gc9n/rx5808-Diversity-RealAcc-Compatible/README.md

<h1>V2.0 OSD Support (Menus-RSSI-Diversity-Battery) Fatshark Button Support</h1>

* Added OSD support for menus
* Ultra fast Real time RSSI feed back
* Ultra fast  Real time Diversity feed back
* PAL or NTSC recognition
* Goggles Battery monitor
* Fatshark Buttons Compatibility
* Favorites enhancement
* "Find Model" Feature

VIDEO

Diversity Module RealAcc with OSD (Real time RSSI-Diversity) and Fatshark button support (https://www.youtube.com/watch?v=VvQDdLFI8oQ)

Instructions 
https://oscarliang.com/realacc-osd-menu-button-support/

Theres an update in Diagram.

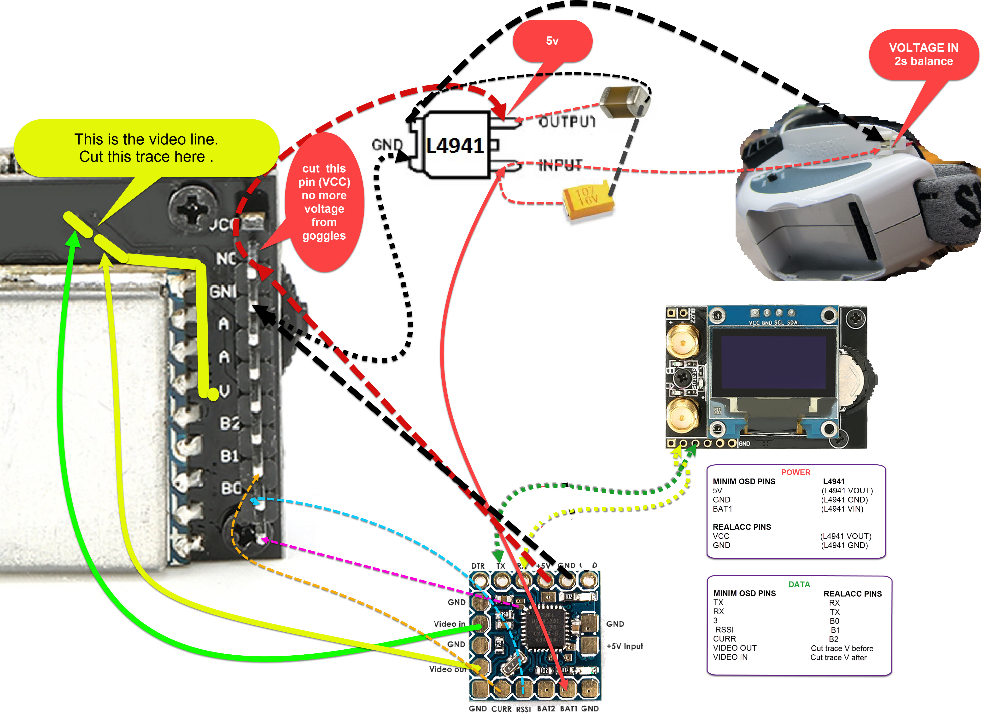
[picture p1: STEPS/STEP THREE (connections)/Realacc - MinimOSD mod .jpg]
 

If this project help you reduce time to develop, you can give me a cup of coffee :)

<a href="https://www.paypal.com/cgi-bin/webscr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" target="_blank">
   
</a> 

# rx5808-Diversity-RealAcc-Compatible
<h1>V1.0 RX5808 Diversity RealAcc Compatible</h1>
Based on sheaivey/rx5808-pro-diversity project

Added extra features with Favorites tab 

 <p align="center">
  
  
</p>

If this project help you reduce time to develop, you can give me a cup of coffee :)

<a href="https://www.paypal.com/cgi-bin/webscr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" target="_blank">
   
</a>
