gc9n/rx5808-Diversity-RealAcc-Compatible/STEPS/instructions.txt

OSD Support (Menus-RSSI-Diversity-Battery)  Fatshark Button Support

* Added OSD support for menus
* Ultra fast Real time RSSI feed back
* Ultra fast  Real time Diversity feed back
* PAL or NTSC recognition
* Goggles Battery monitor
* Fatshark Buttons Compatibility
* Favorites enhancement

VIDEO
Diversity Module RealAcc with OSD (Real time RSSI-Diversity) and Fatshark button support (https://www.youtube.com/watch?v=VvQDdLFI8oQ)

<h1>Powering the module from deferent power source</h1>
 What I realized is that the Fatshark Goggles have an internal regulator 5v that feeds the Video RX module when we plug it in … is less than 500mha. I came to that conclusion because 
RealAcc div module works at 340mha
Microminim OSD works at 100mha
Total 440mha.. The micro minim OSD cannot start combined with the realacc module. 

Plus all those Diversity modules on the market makes our goggles sensitive because  they 
pull as much current as much the glasses can not give . Fatsharks are not designed to give that current , they work  close to the limit!!  . IMHO There is danger if you use diversity modules with the goggles , you pushing them to the limit.

So i made a decision, I didn’t want to open the goggles for any reason, so I had to find a way to power the module from a different power source. With an easy and clean method, without any modifications to the goggles it self.

Then I saw the fan from the face plate! , so I just took power from the balance plug that feeds the little fan . I used those cables http://www.banggood.com/DIY-1_25mm-2-Pin-Micro-Male-Female-Connector-Plug-Cable-for-RC-LIPO-Battery-FPV-Drone-Quadcopter-p-1080391.html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
+ i can get goggles battery monitor!

Now the power for the module is independent, 
After that little mod that makes my goggles more “healthier” from damaging the regulator with those power demanding modules, I added into the realacc module a  STMicroelectronics L4941BDT-TR 
LDO Voltage Regulator 5.0V 1.0A Positive, 
http://www.mouser.com/ds/2/389/l4941-973941.pdf
CAUTION THIS NEED TWO CAPACITORS ONE INTO VIN AND GROUND tantalum cap, AND ONE IN THE VOUT AND GROUND  A CERAMIC CAP

<h1>INSTRUCTIONS  FOR THE SOFTWARE </h1>
 Download the https://github.com/gc9n/rx5808-Diversity-RealAcc-Compatible/releases/download/V2.0/MICRO.MINIM.OSD.SOFTWARE.zip

<h2>Preparation for MicroMinim OSD</h2>
<h3>Fonts</h3>
In order to upload the fonts to Microminim OSD the easiest method is the MW_OSD project.
* connect the microminim osd to pc 
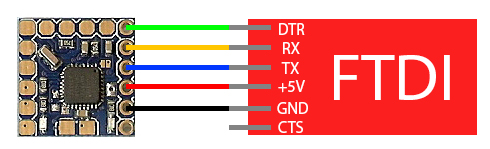
[picture p2: STEPS/PART FOUR (Connections)/MicroMinimOSD-FTDI.jpg]

* upload the MW_OSD.ino.hex to Microminim OSD
* open MW_OSD_GUI.exe
* Connect to the MicroMinim
* Font Tools > select the  polyphemous_Charset .mcm
* upload.
* Done with Fonts.

If you are not familiar with this process you can follow this video https://www.youtube.com/watch?v=svIjwDp8T60 , and when your in the part of fonts you choose polyphemous_Charset .mcm from zip file.

<h3>PolyPhemus</h3>
Upload the PolyPhemus.ino.hex into the MicroMinimOSD

<h2>Preparation for RealAcc</h2>
Upload the rx5808-pro-diversityGc9n.ino.hex

<h1>INSTRUCTIONS  FOR THE HARDWARE</h1>
<h2>The Goggles FacePlate mod</h2>
We have to take external power because fatsharks internal voltage regulator not giving at least 0.5amp of current SO.
In my humble opinion everyone that uses diversity module of any brand have to make this little mod.
You are not "hurting" your goggles. Your goggles stays intact .

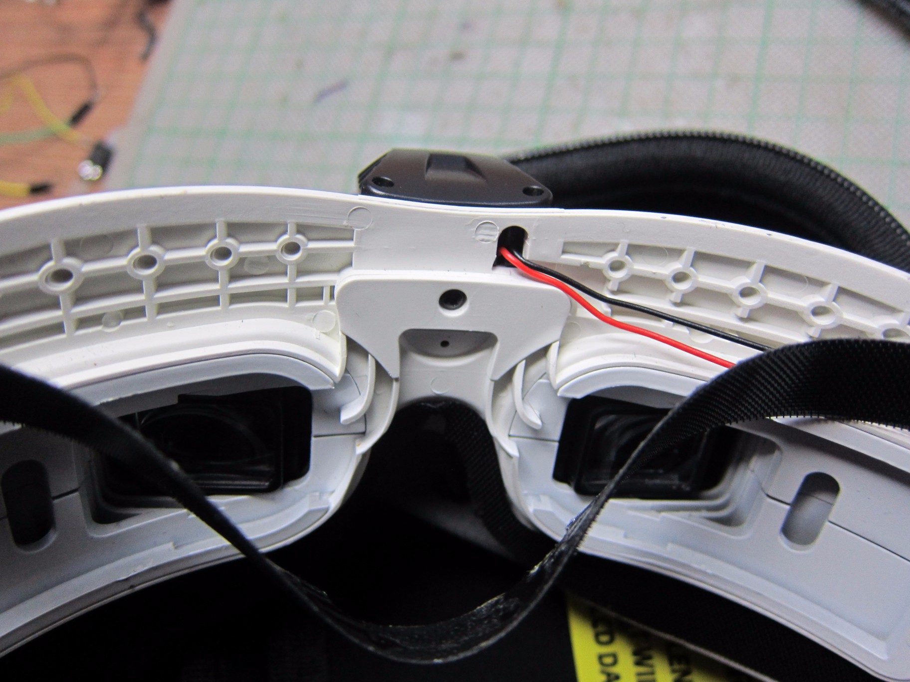
[picture p3: STEPS/STEP ONE (FacePlate)/1.JPG]

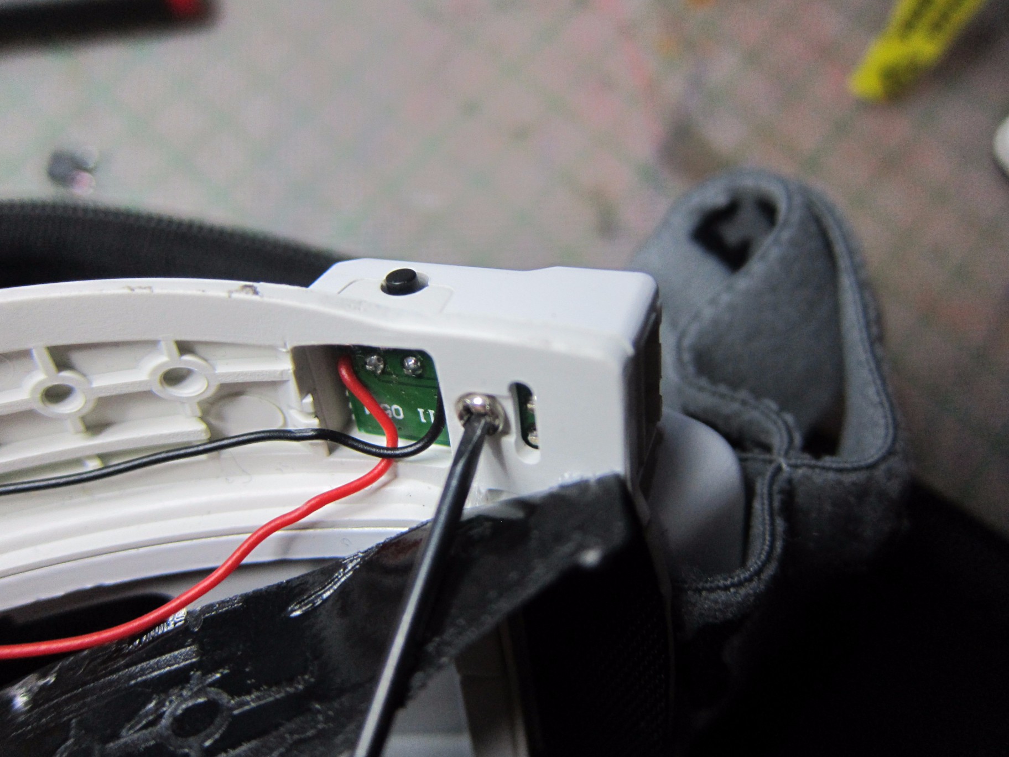
[picture p4: STEPS/STEP ONE (FacePlate)/2.JPG]

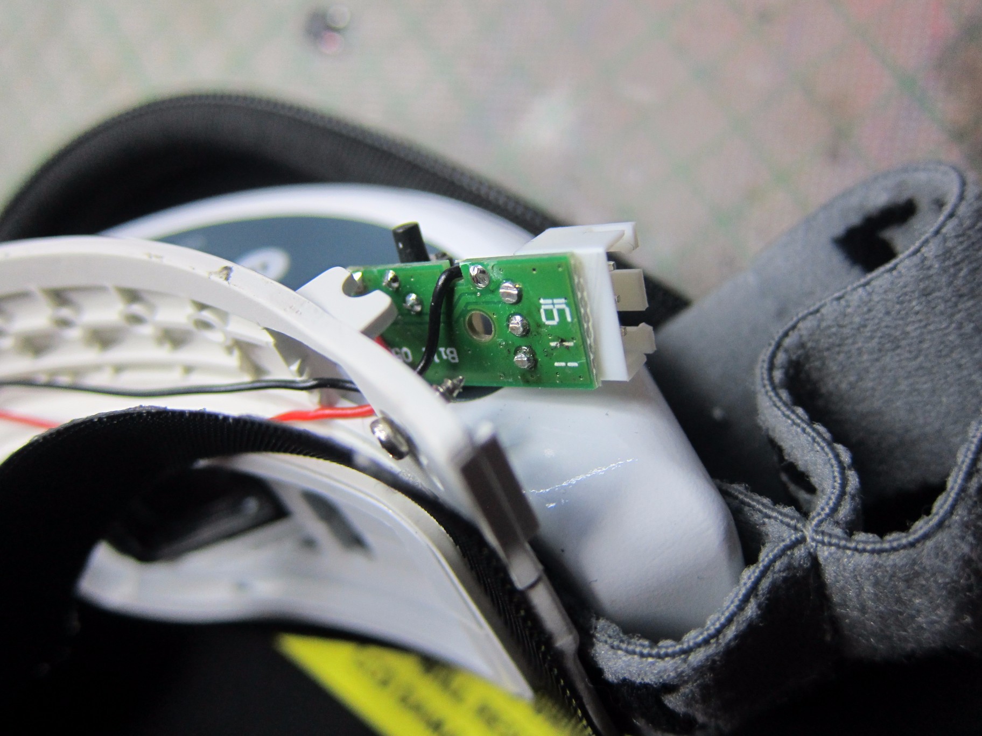
[picture p5: STEPS/STEP ONE (FacePlate)/3.JPG]

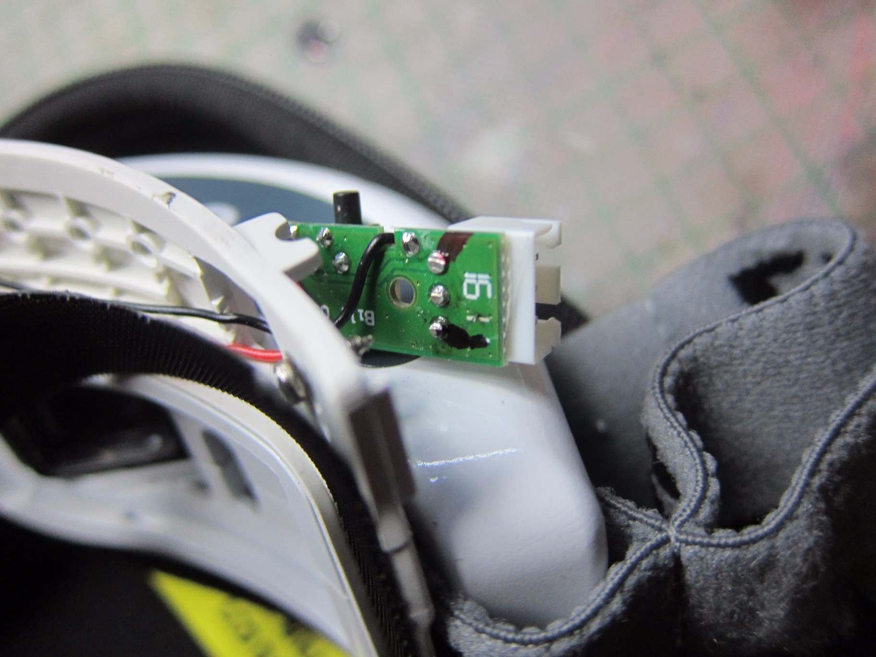
[picture p6: STEPS/STEP ONE (FacePlate)/4.JPG]

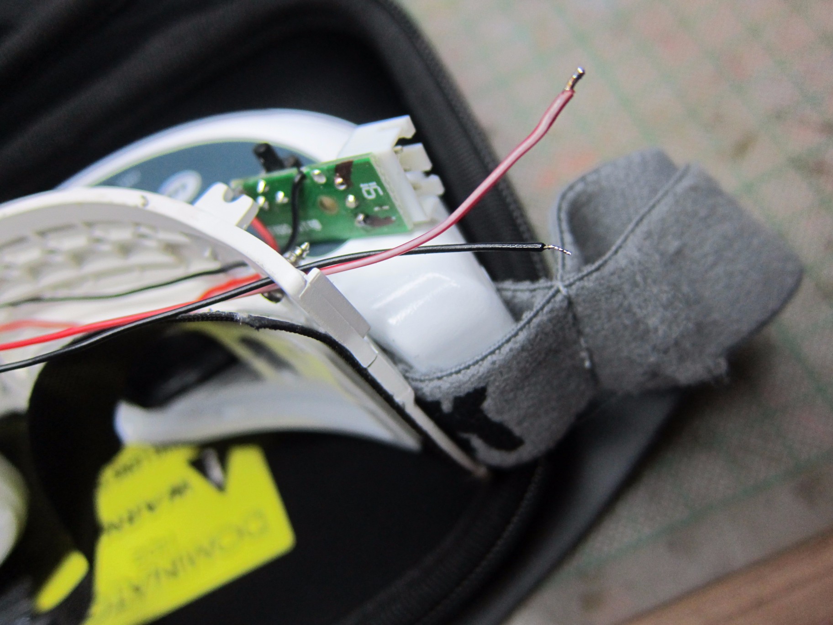
[picture p7: STEPS/STEP ONE (FacePlate)/5.JPG]

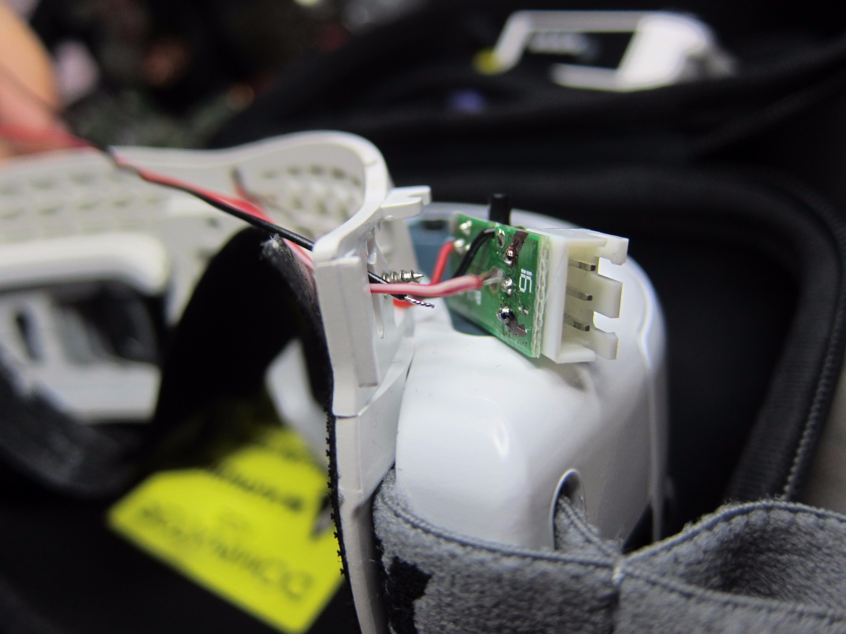
[picture p8: STEPS/STEP ONE (FacePlate)/6.JPG]

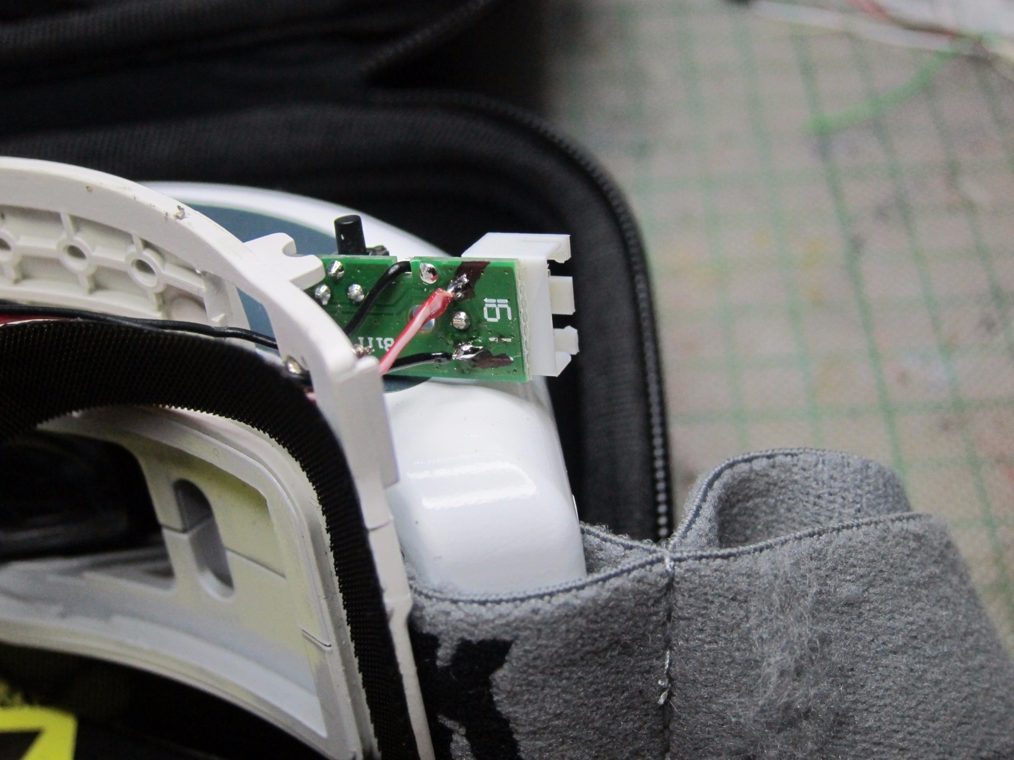
[picture p9: STEPS/STEP ONE (FacePlate)/7.JPG]

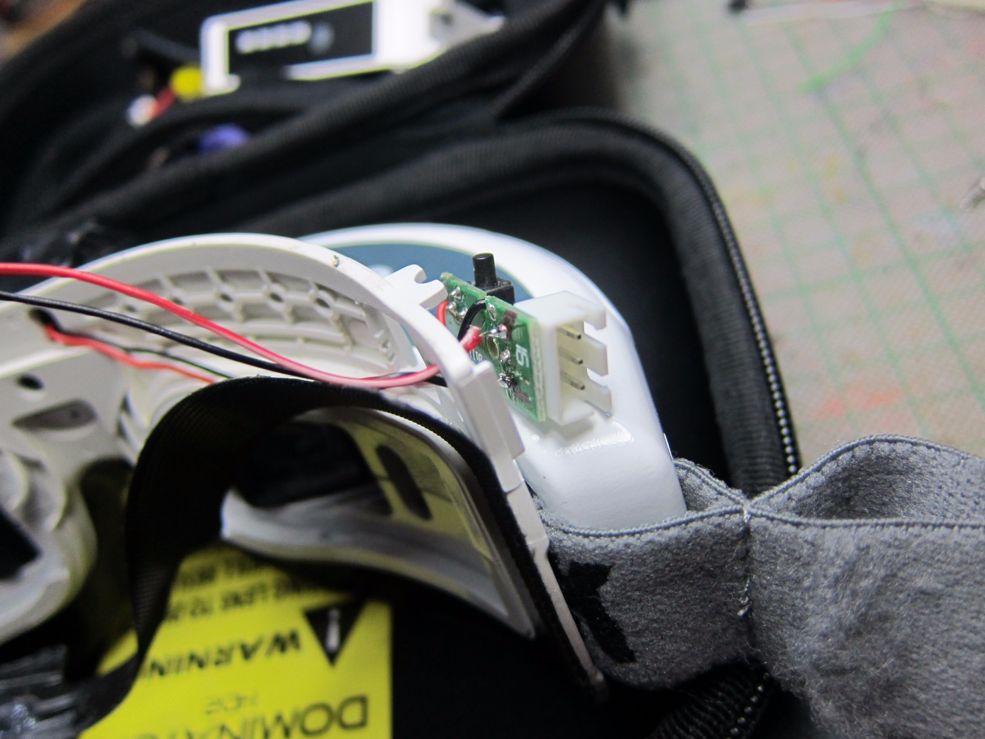
[picture p10: STEPS/STEP ONE (FacePlate)/8.JPG]

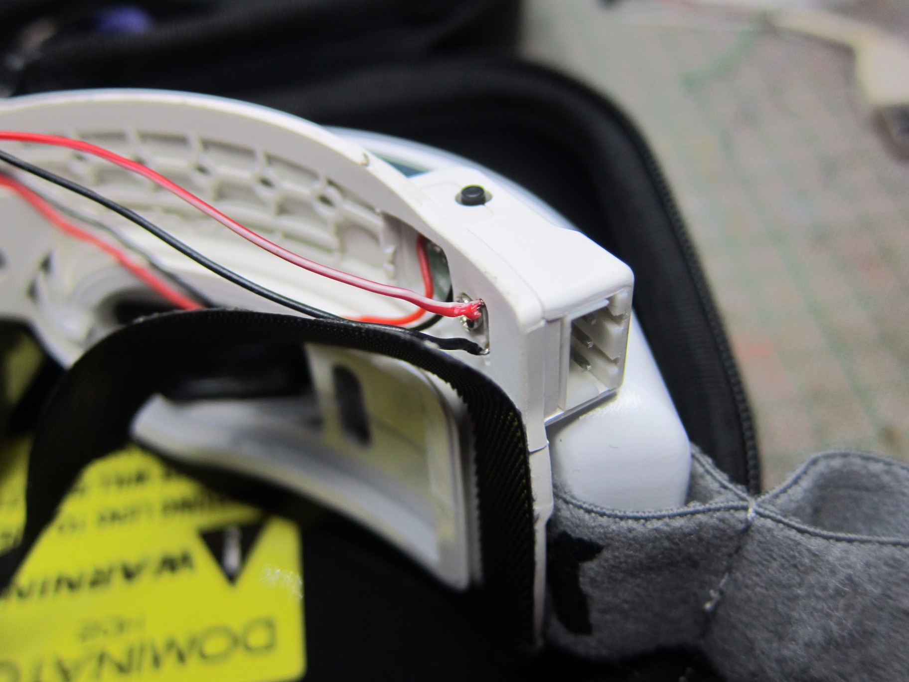
[picture p11: STEPS/STEP ONE (FacePlate)/9.JPG]

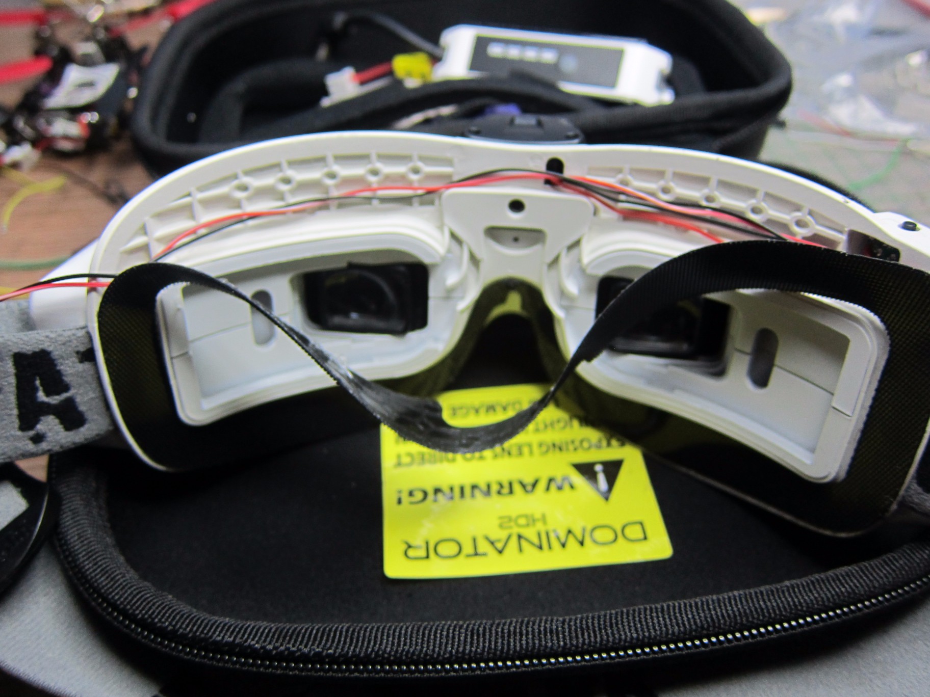
[picture p12: STEPS/STEP ONE (FacePlate)/10.JPG]

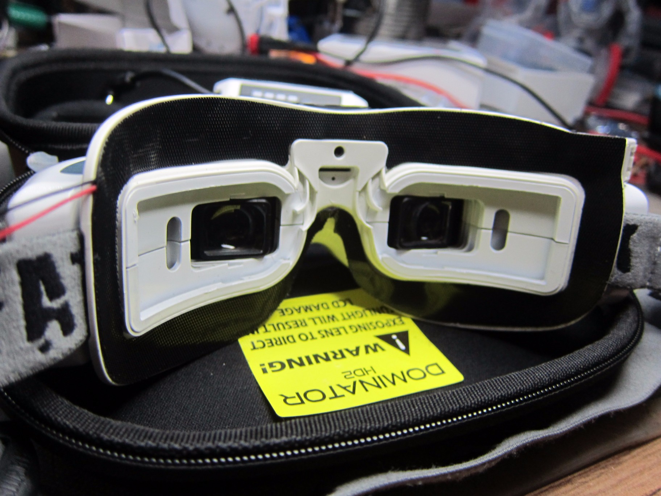
[picture p13: STEPS/STEP ONE (FacePlate)/11.JPG]

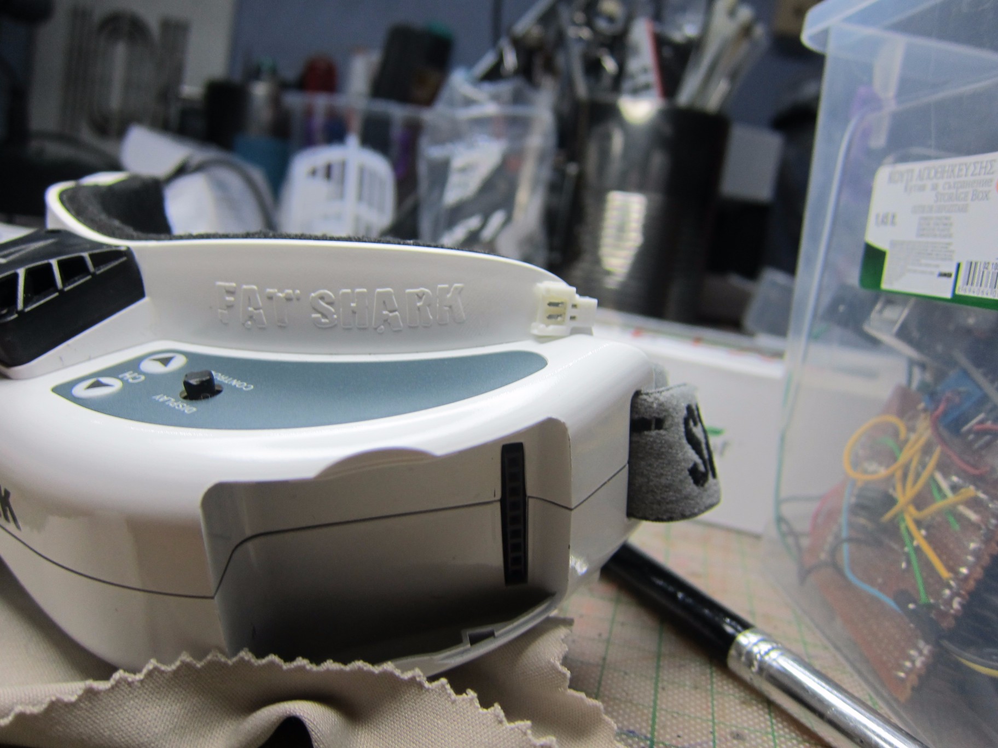
[picture p14: STEPS/STEP ONE (FacePlate)/12.JPG]

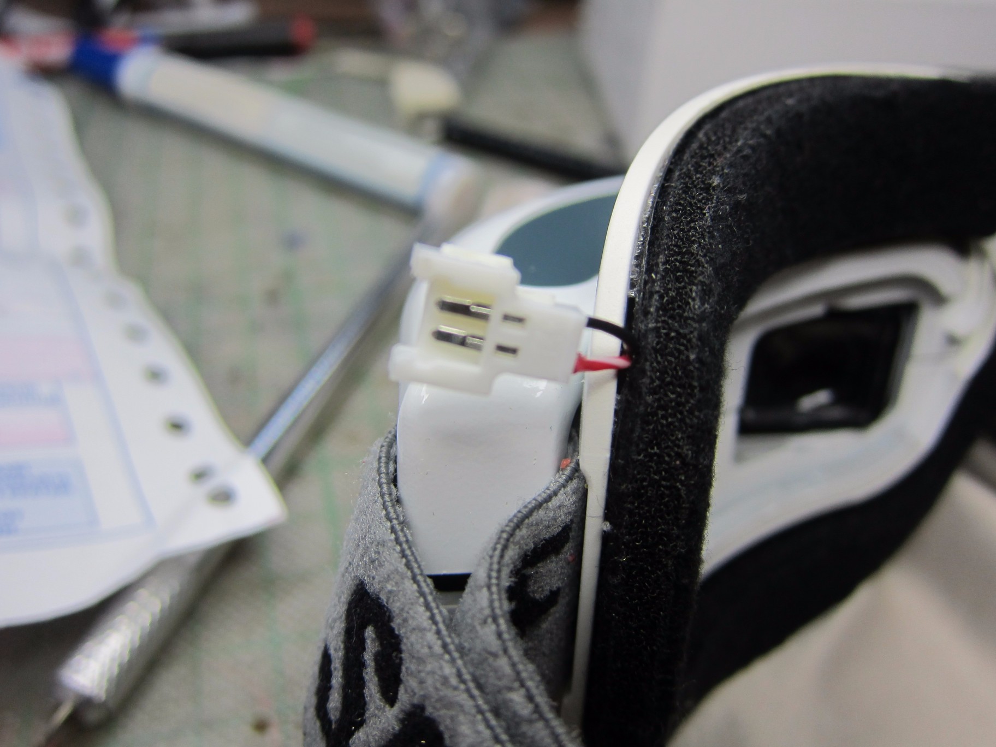
[picture p15: STEPS/STEP ONE (FacePlate)/13.JPG]

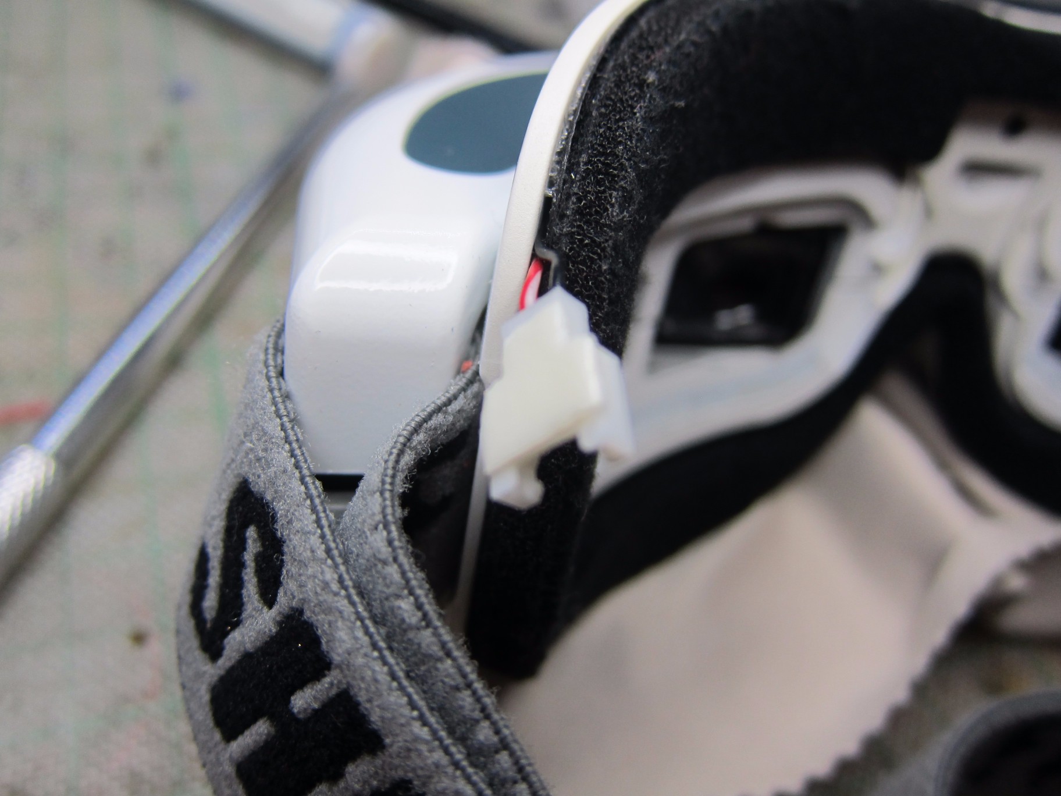
[picture p16: STEPS/STEP ONE (FacePlate)/14.JPG]

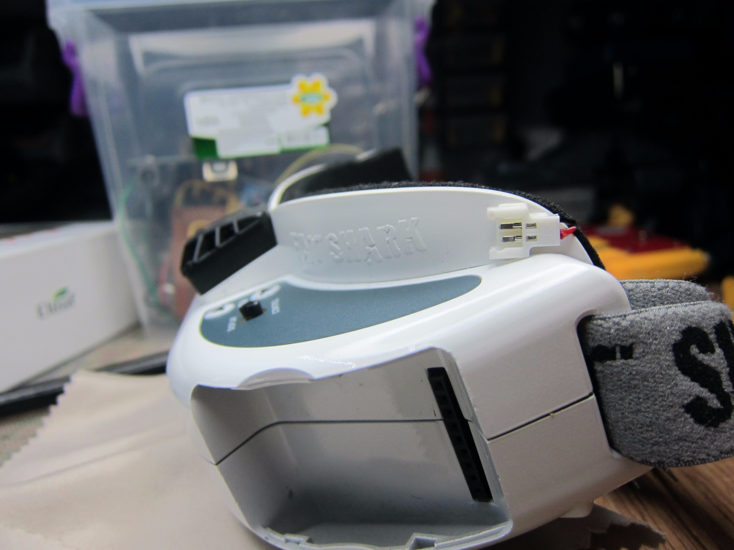
[picture p17: STEPS/STEP ONE (FacePlate)/15.JPG]

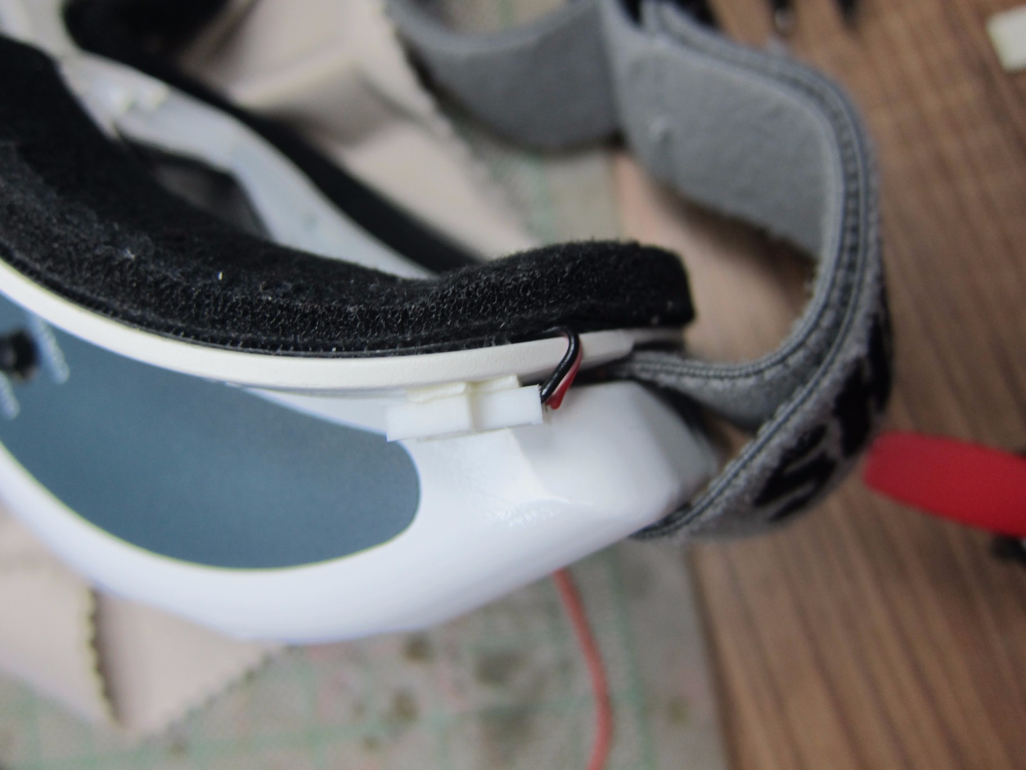
[picture p18: STEPS/STEP ONE (FacePlate)/16.JPG]


Voltage Regulator For Module

I added into the realacc module a  STMicroelectronics L4941BDT-TR 
LDO Voltage Regulator 5.0V 1.0A Positive, 
http://www.mouser.com/ds/2/389/l4941-973941.pdf

This regulator is capable to work with input power close to 5v , other regulators in order to give 5v they have to take at least 7.2v
so L4941 is way to go.

The L4941 Needs 2 capacitors . 
one Ceramic capacitor 
http://www.electronic.it/open2b/var/products/372/59/0-db6562e0-500-0805-SMD-ceramic-capacitor-22nF-conf.100pz.jpg

and one tantalum type capacitor  (the line is showing the POSITIVE)
http://www.radio-electronics.com/images/tantalum-smd-capacitor-code.jpg

I found a ceramic capacitor from an old cd rom drive. i just found the right physical dimension.
this goes between the out pin of the L4941 and ground (polarity doesnt matter)

i scavenge a tantalum electrolytic capacitor from this cd rom drive also ! , i just cross check the 
letters and found on the web that is 10v 
this goes between the in pin of the L4941 and ground (polarity matters! the little line is the positive so you have to solder it in VIN pin of the  L4941)

We scratch off the paint in this area carefully (it’s basically electrical ground) , and we solder the bottom (GND) of 5V regulator on to it.
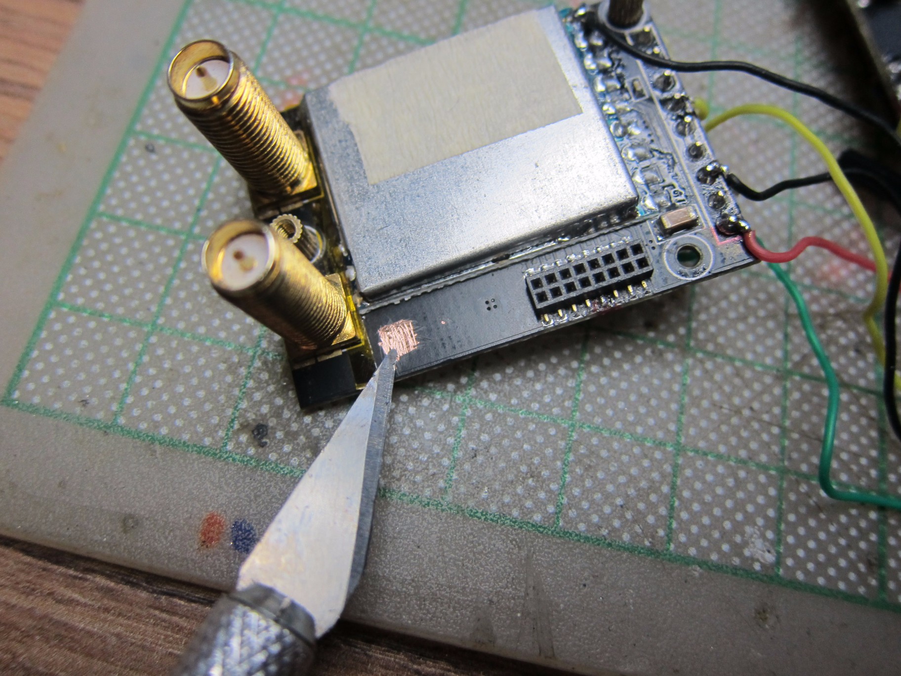
[picture p19: STEPS/STEP TWO (Voltage regulator for module)/0.jpg]


We apply solder , and we gother the reg and the caps.
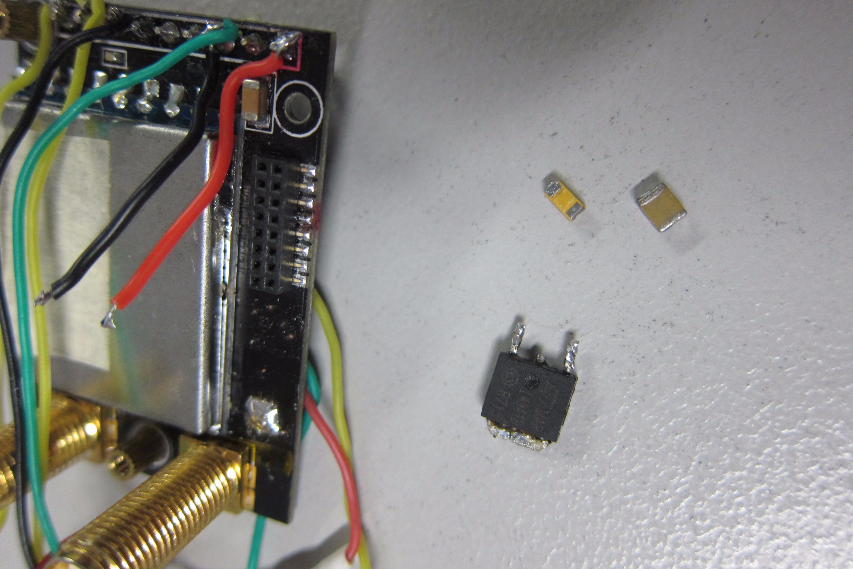
[picture p20: STEPS/STEP TWO (Voltage regulator for module)/1.JPG]


the legs of the regulator is in the air.  
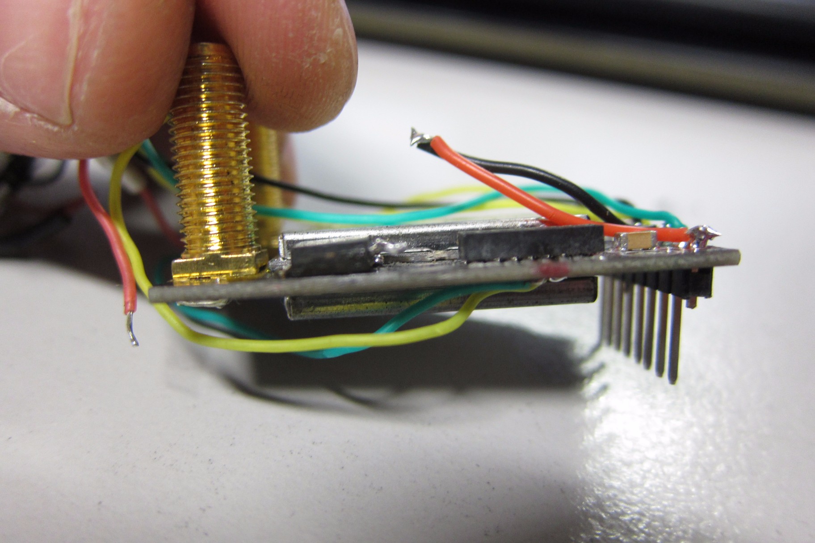
[picture p21: STEPS/STEP TWO (Voltage regulator for module)/3.JPG]


now if you look closer i scrach the pad (is ground) to solder the caps.
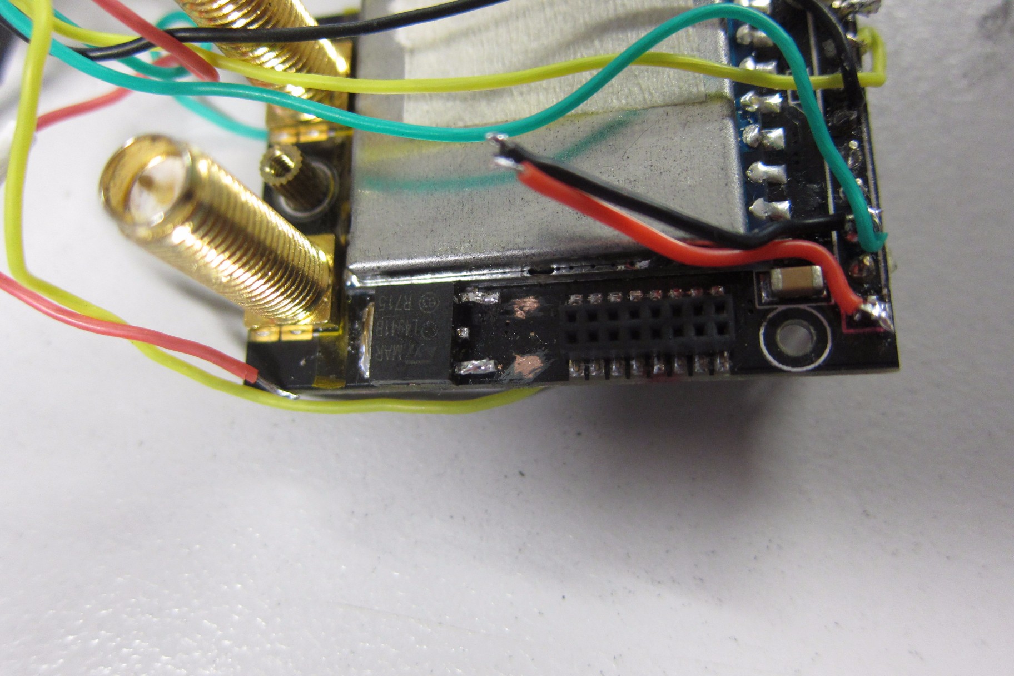
[picture p22: STEPS/STEP TWO (Voltage regulator for module)/2.JPG]


We apply solder ,
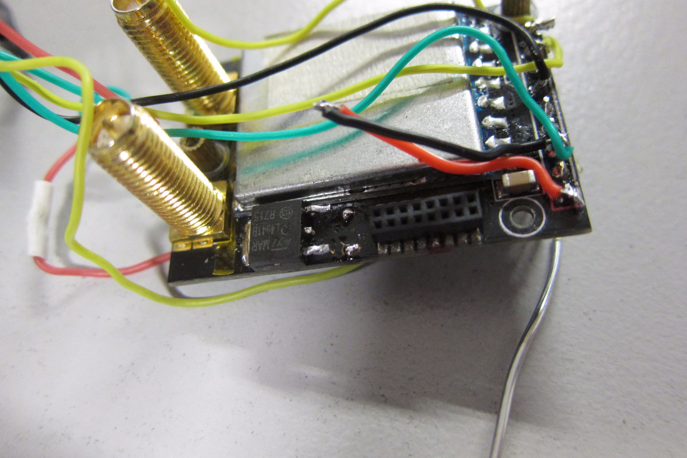
[picture p23: STEPS/STEP TWO (Voltage regulator for module)/4.JPG]


tandalum to VIN and GROUND.
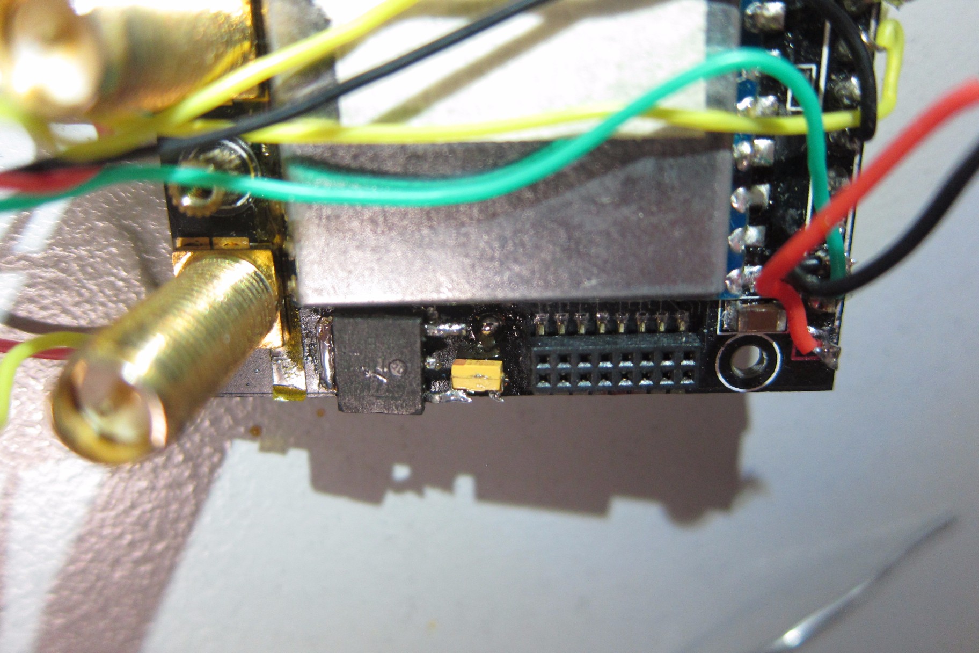
[picture p24: STEPS/STEP TWO (Voltage regulator for module)/5.JPG]


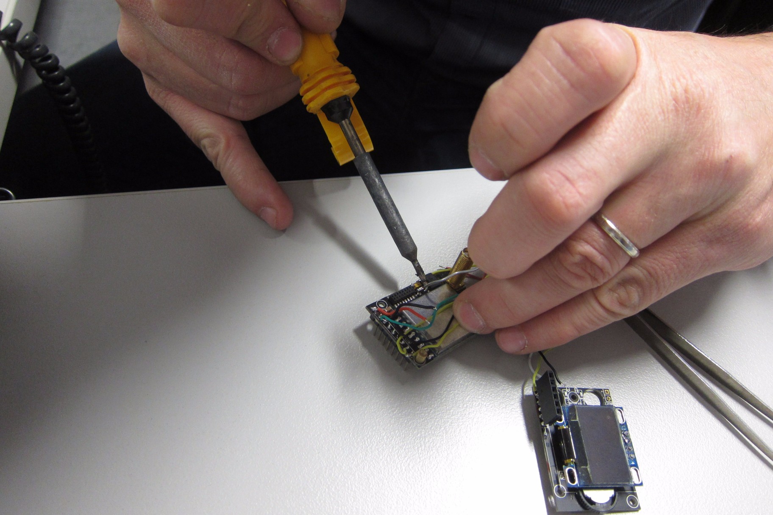
[picture p25: STEPS/STEP TWO (Voltage regulator for module)/6.JPG]


ceramic is place
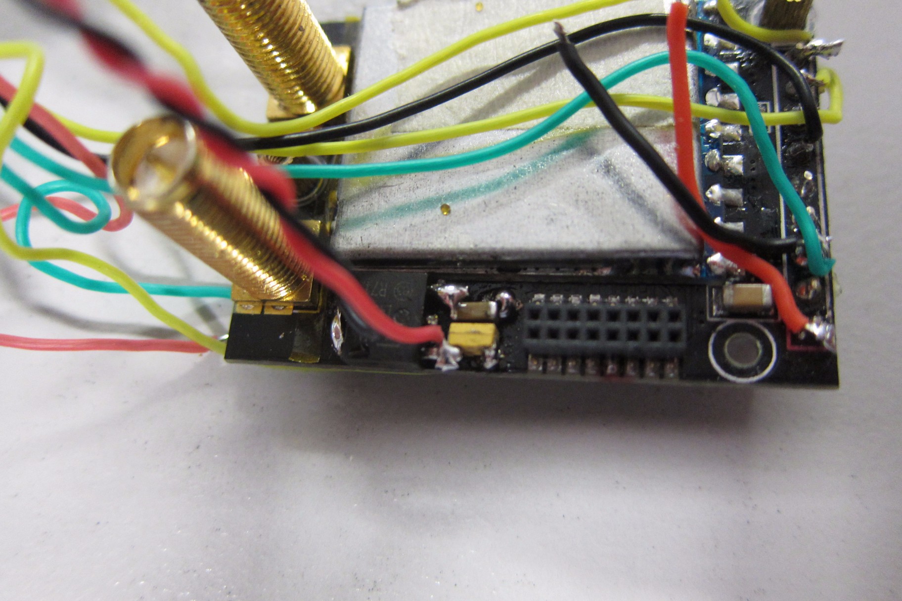
[picture p26: STEPS/STEP TWO (Voltage regulator for module)/7.JPG]


Positive negative  wire .. the negative is the back of the reg
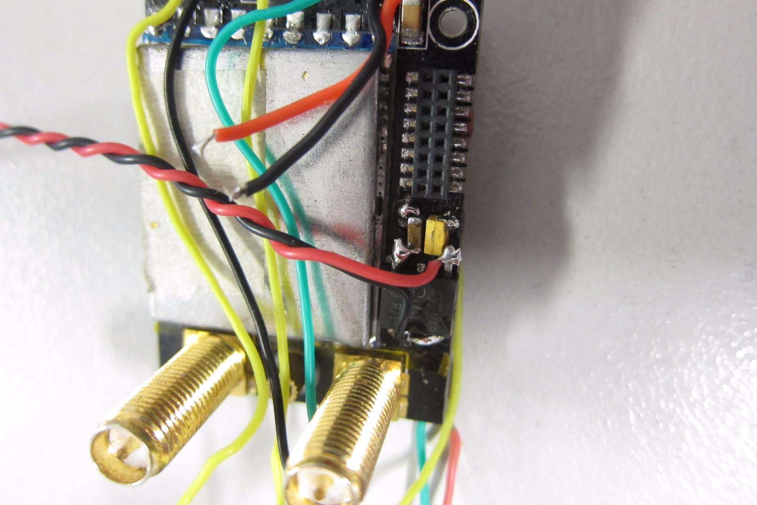
[picture p27: STEPS/STEP TWO (Voltage regulator for module)/8.JPG]


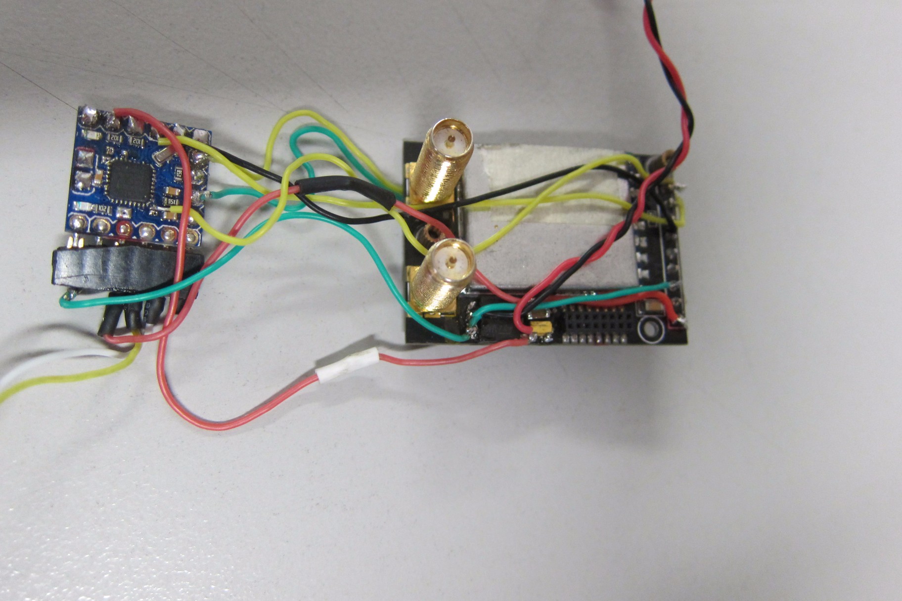
[picture p28: STEPS/STEP TWO (Voltage regulator for module)/9.JPG]


<h2>VIDEO IN AND OUT</h2>
This is the most important part , this is were you split the video in half and you give it to the OSD and OSD returns the Overlay .

Carefully start scratching this line to peal off the paint
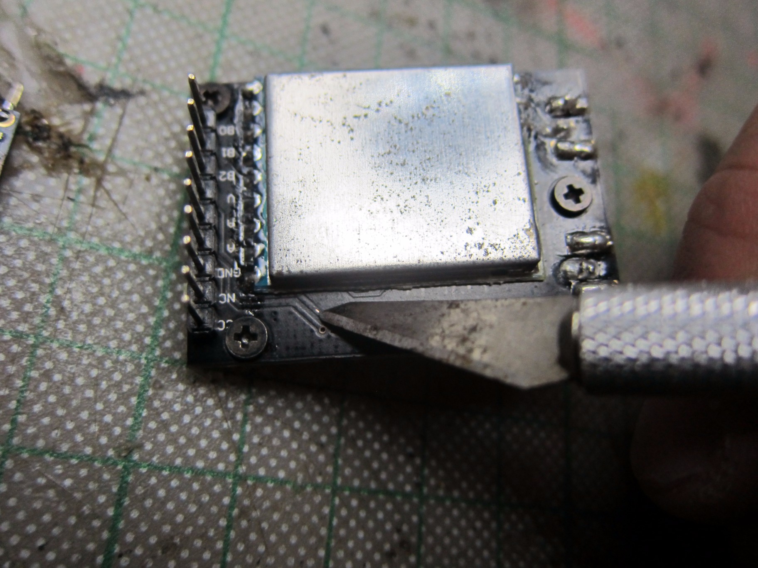
[picture p29: STEPS/PART FOUR (Connections)/10.jpg]


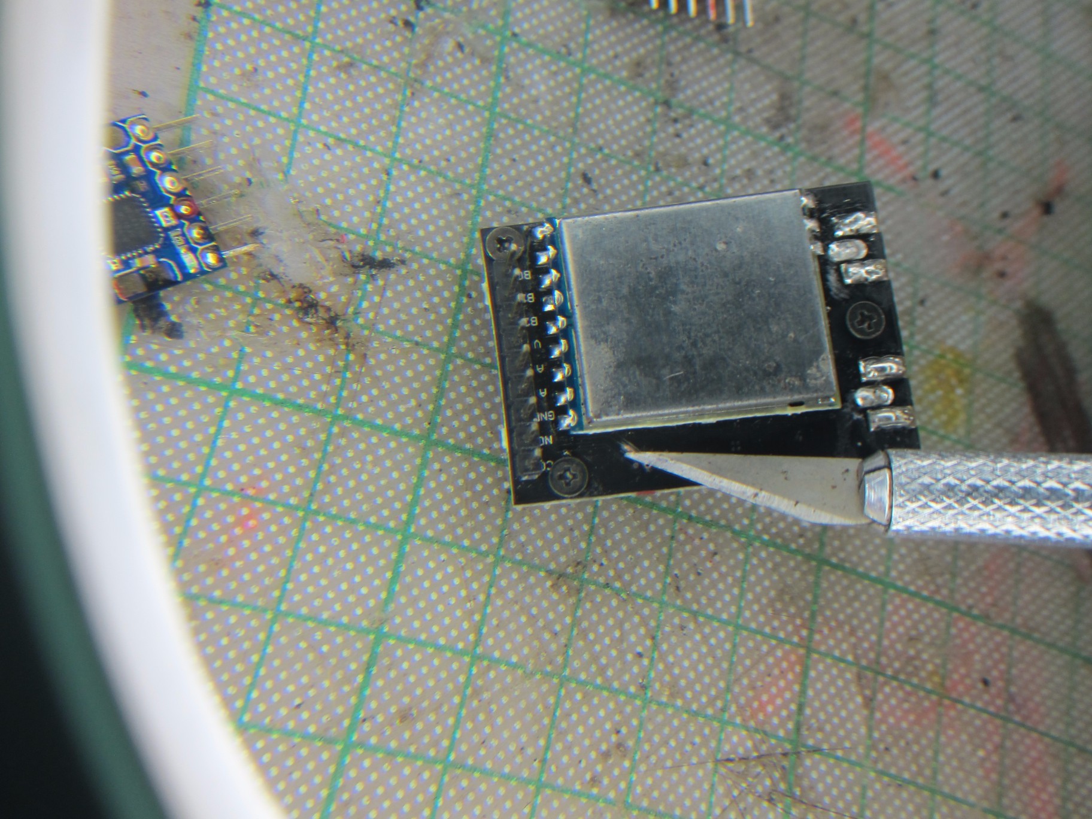
[picture p30: STEPS/PART FOUR (Connections)/11.jpg]


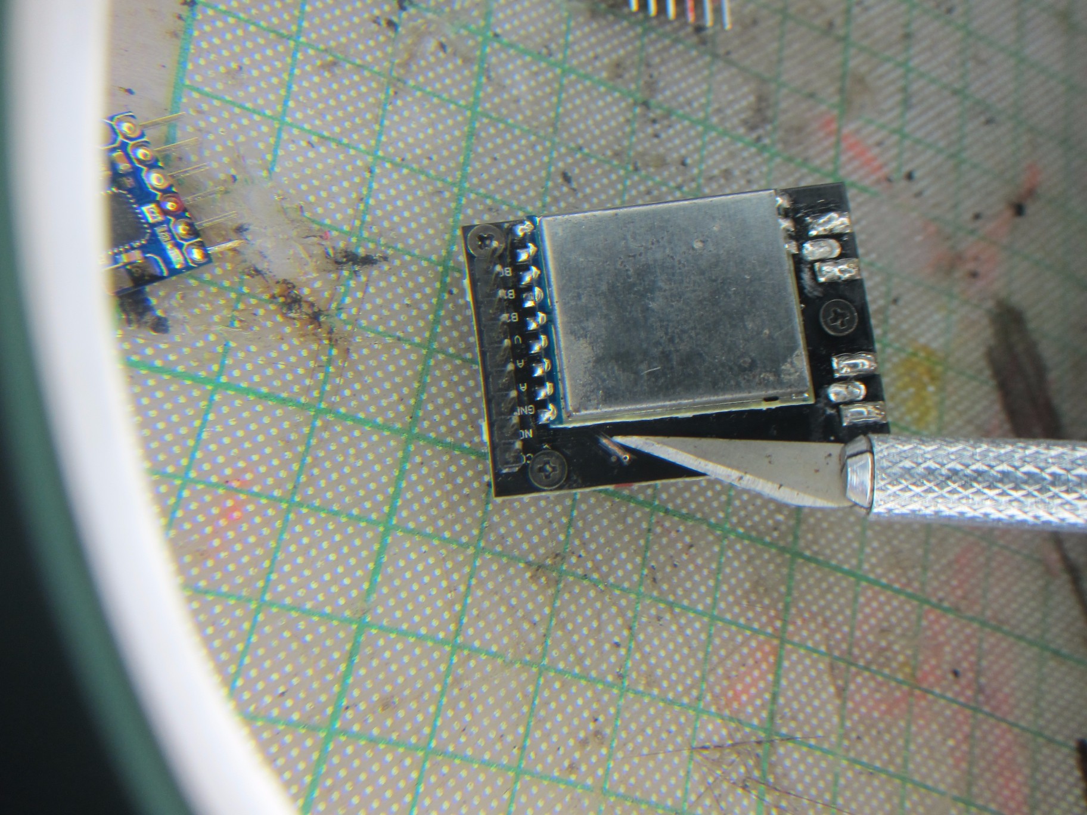
[picture p31: STEPS/PART FOUR (Connections)/12.jpg]


now separate this line , cut it in half , and connect to the osd , see pic bellow

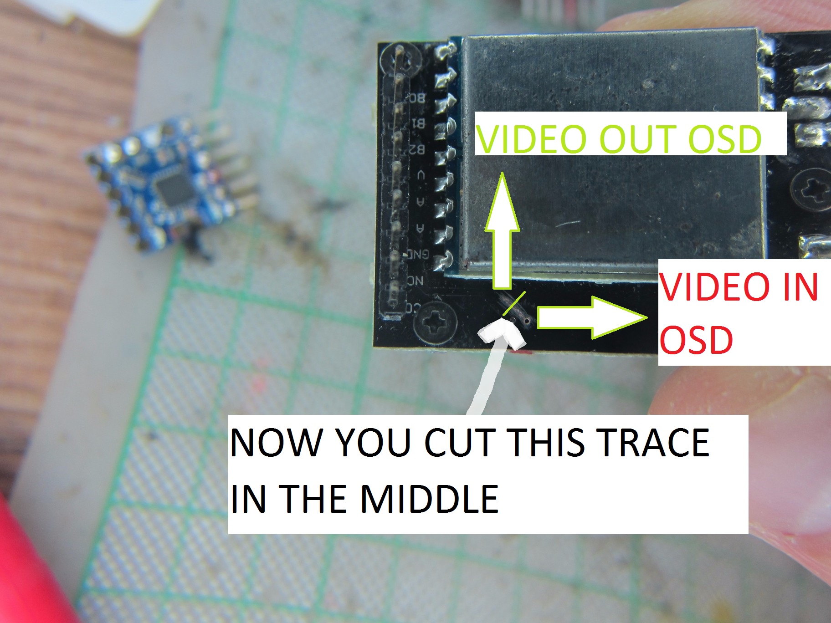
[picture p32: STEPS/PART FOUR (Connections)/13.jpg]


And looks like this 

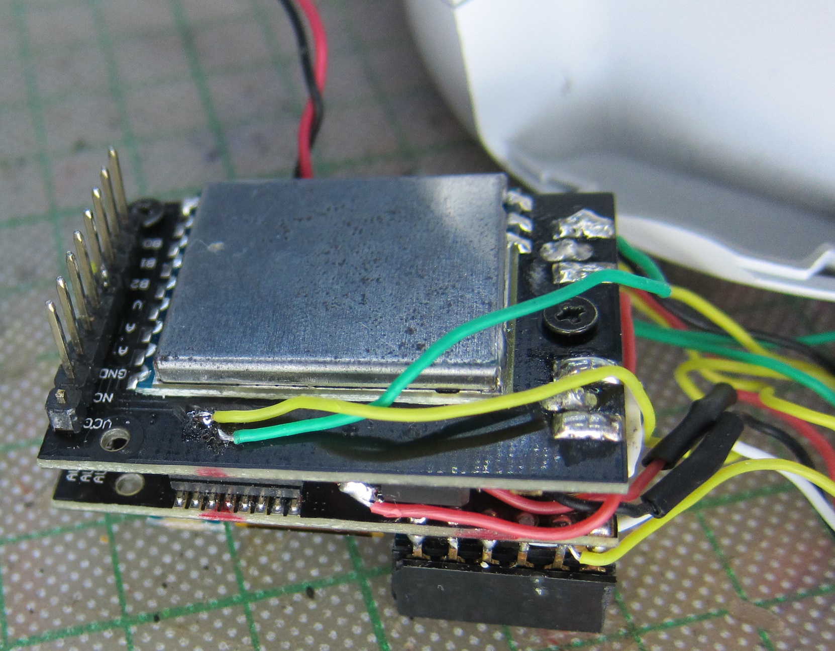
[picture p33: STEPS/PART FOUR (Connections)/vinvout.jpg]


 <h2>Cut the VCC pin from the RealAcc Module!!!</h2>
 <h2>And also Cut the VCC pin from the RealAcc Module!!!</h2>
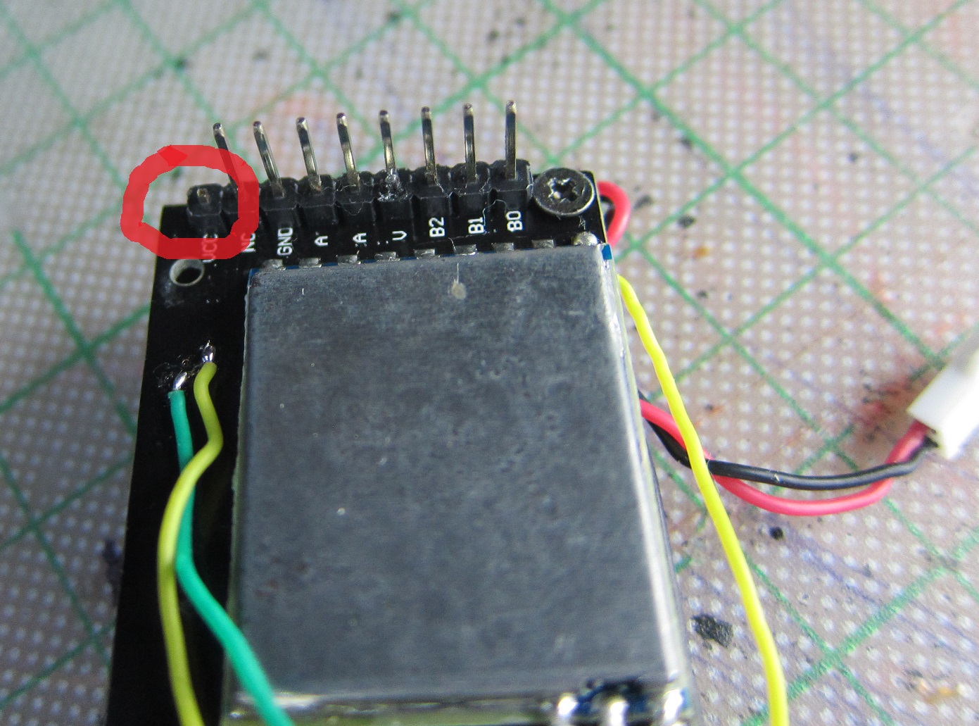
[picture p34: STEPS/PART FOUR (Connections)/pinvcc.jpg]


 <h1>The Connection Diagram </h1>



<h2> Important notice </h2>
You have to consider how your gonna connect the FTDI part of the micro minim osd (RX TX VCC GND) . it have to be disconnected from realacc module easily because if you want to upgrade your firmware in osd or in diversity module they have to be separate. you can see in this pic that i insert Female headers into the osd, in order to take it apart from the module.

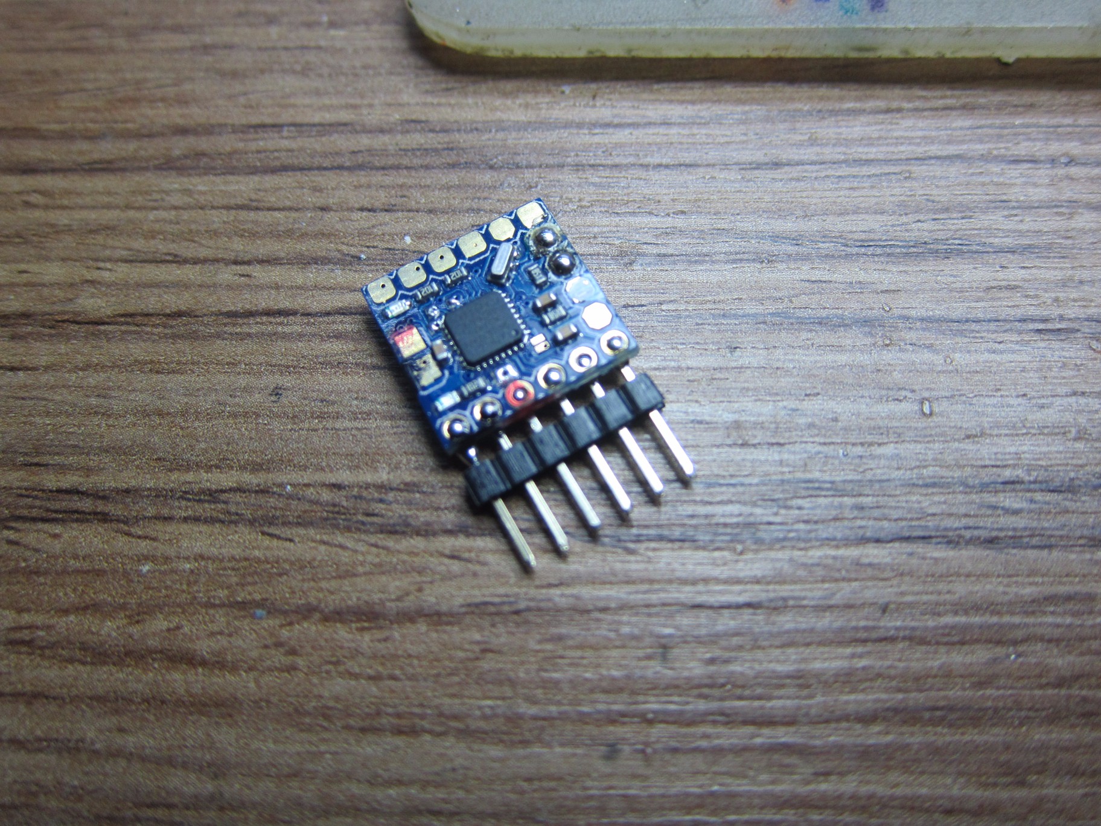
[picture p35: STEPS/PART FOUR (Connections)/1.jpg]


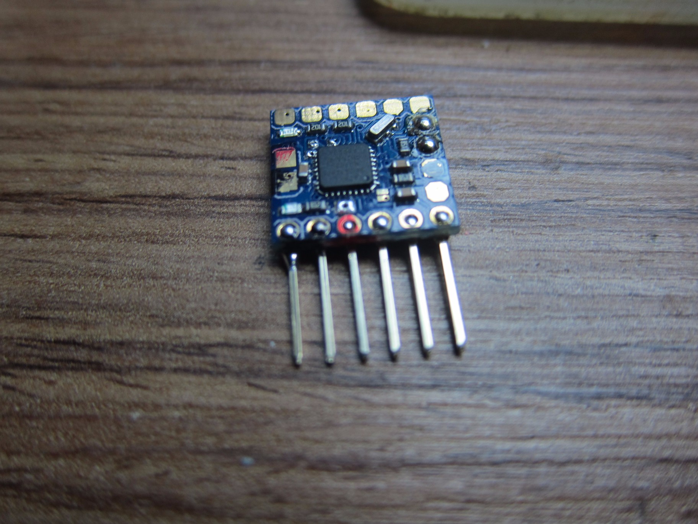
[picture p36: STEPS/PART FOUR (Connections)/2.jpg]

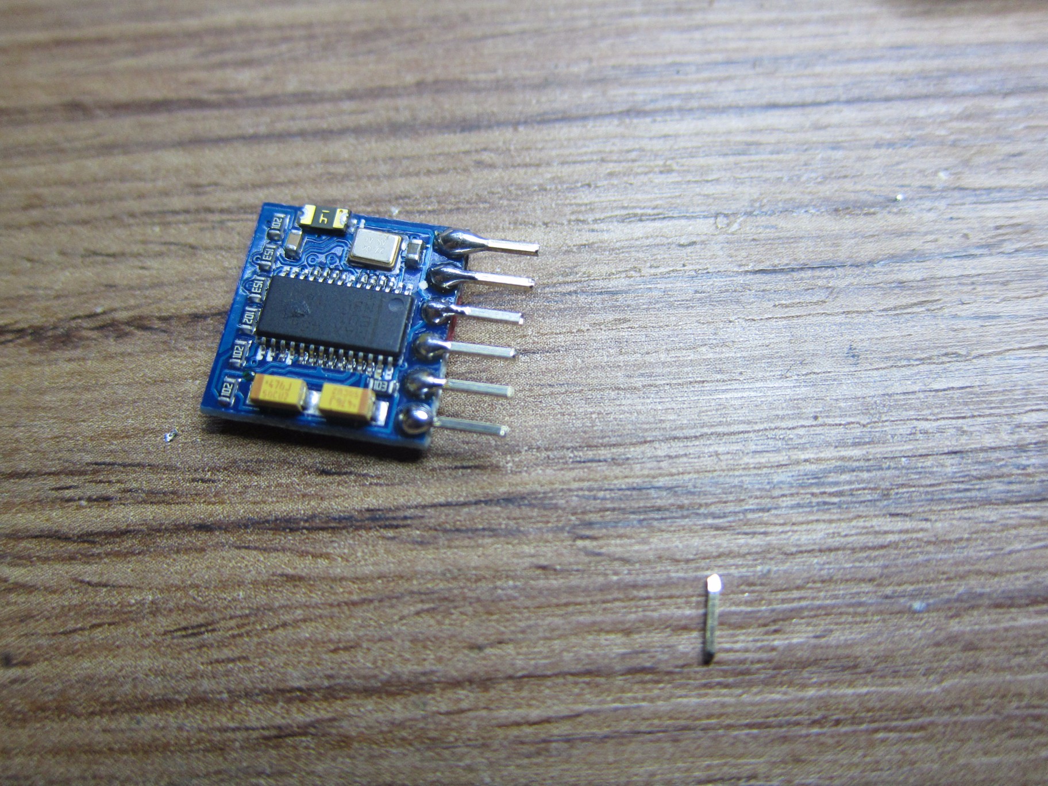
[picture p37: STEPS/PART FOUR (Connections)/3.jpg]

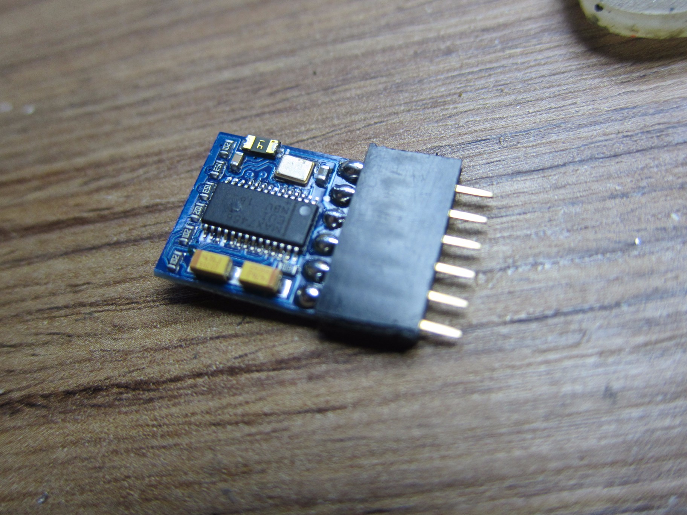
[picture p38: STEPS/PART FOUR (Connections)/4.jpg]

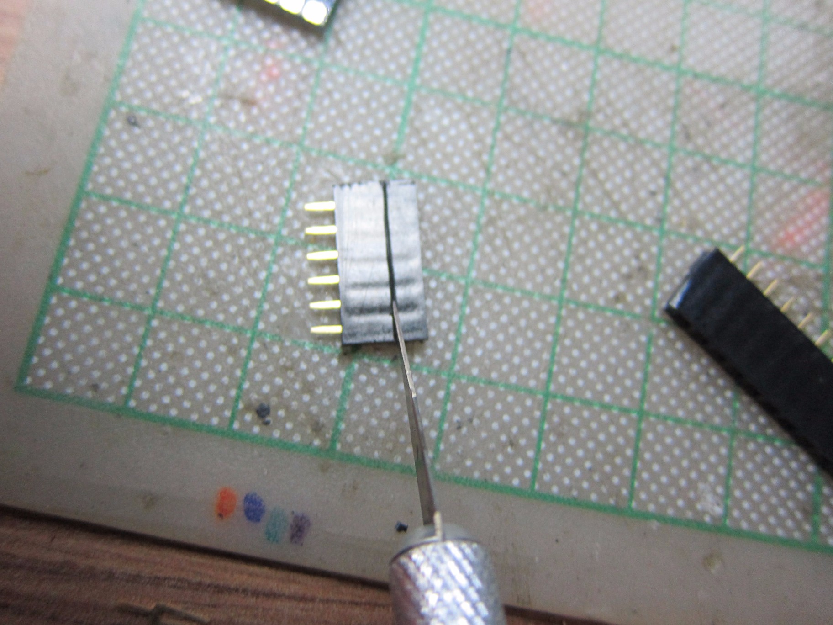
[picture p39: STEPS/PART FOUR (Connections)/5.jpg]

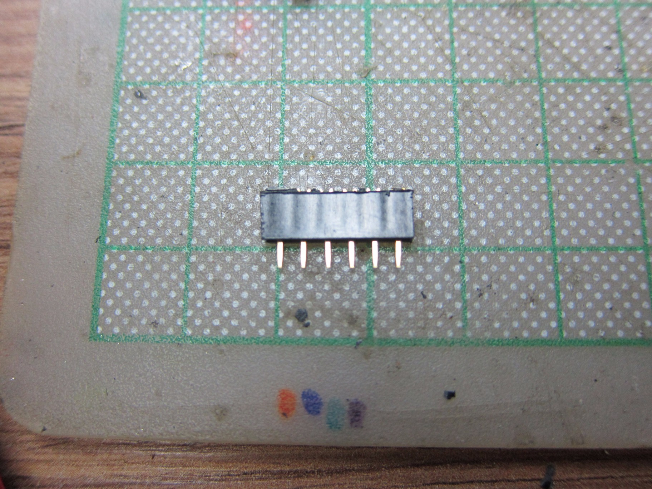
[picture p40: STEPS/PART FOUR (Connections)/6.jpg]

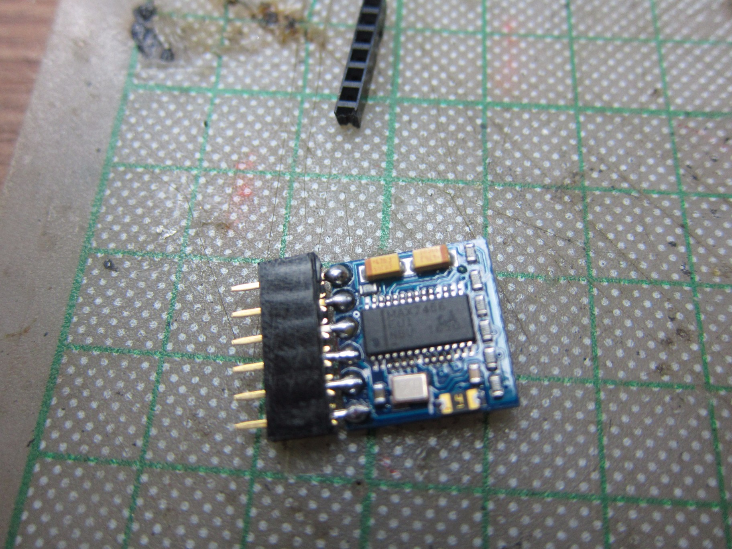
[picture p41: STEPS/PART FOUR (Connections)/7.jpg]

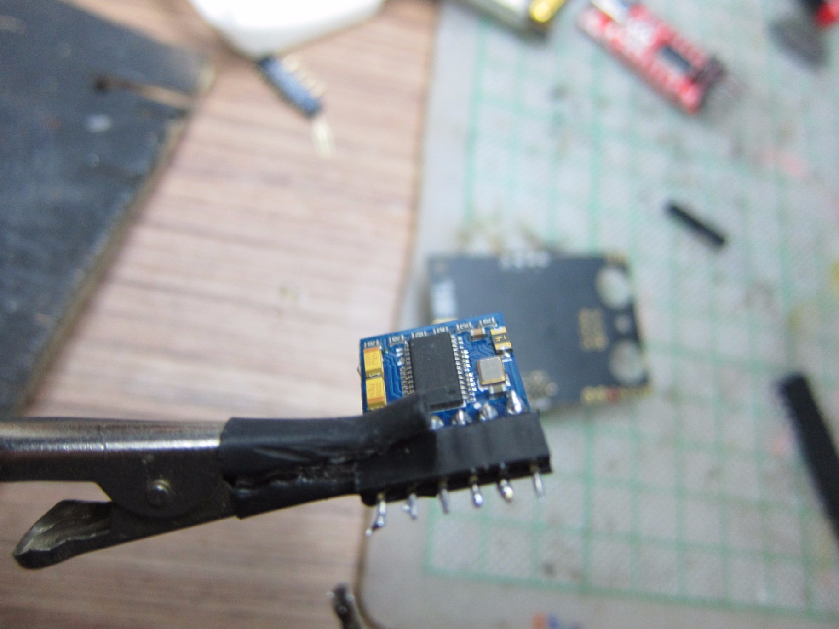
[picture p42: STEPS/PART FOUR (Connections)/8.jpg]

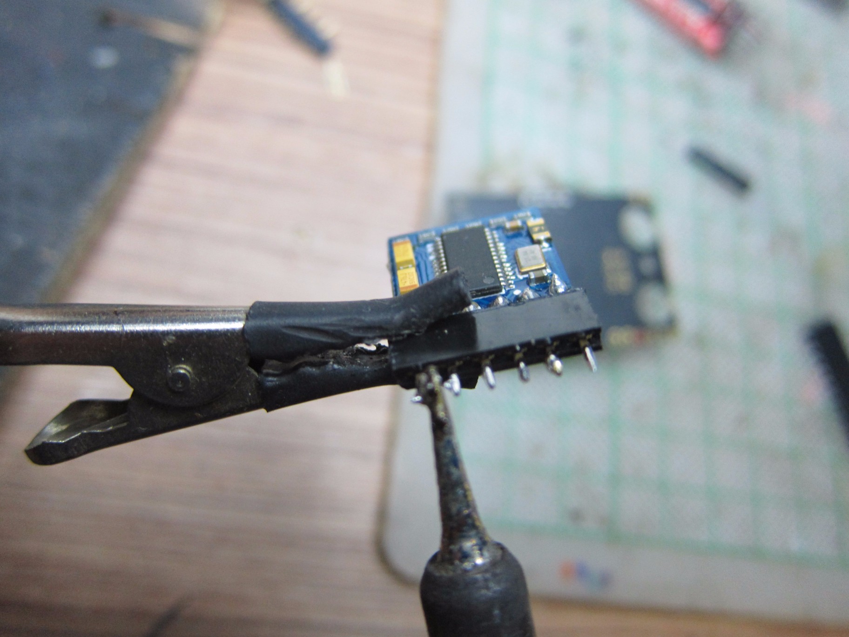
[picture p43: STEPS/PART FOUR (Connections)/9.jpg]


<h1> To do ! </h1>

After hours-days  of research and development  , try  and error , disappointment ,satisfaction, anger , happiness . 
i came up with this spaghetti! 
now i have to clear up the wires and snag the osd under oled 
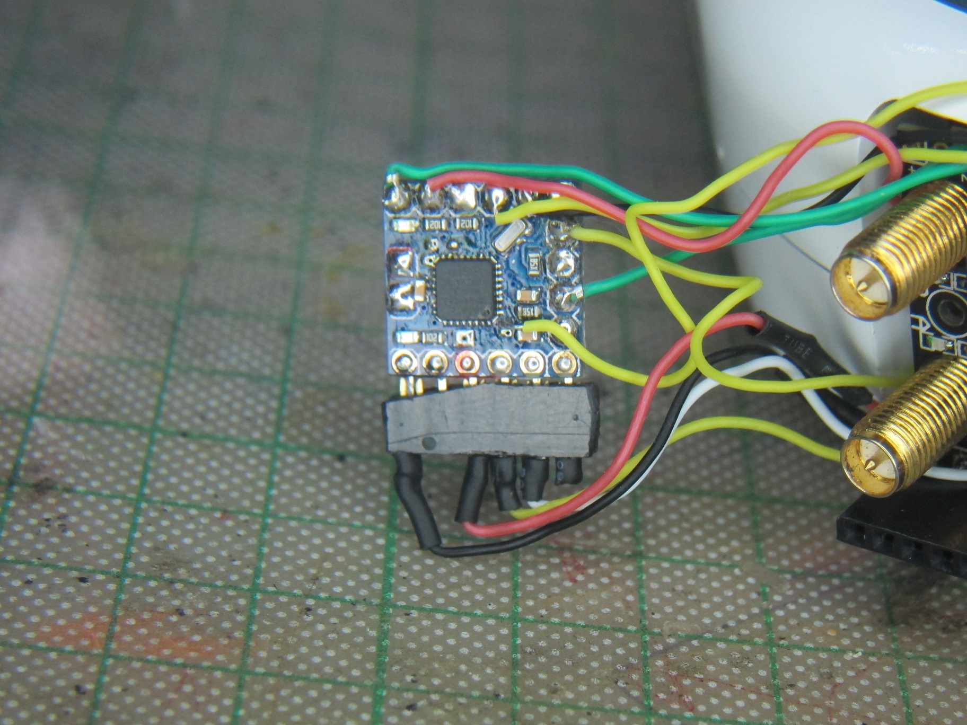
[picture p44: STEPS/PART FOUR (Connections)/IMG.jpg]
