gc9n/rx5808-Diversity-RealAcc-Compatible/(threads)

Thread 1 (2016-10-29):

Mergin with rx5808-diveristy-pro

kabturek, 2016-10-29:
I like your work @gc9n  - did you try merging it with the official rx5808-diversity-pro ?

I'm not sure how the original is managed ( my PR are hanging there) but it would be great to have all the functions in one place as now they're  scattered between forks.

gc9n, 2016-10-29:
thanks man
do you believe that owner will be positive to that?
because if i merge it , his commersial product have this feature, so people
will buy the cheap one.

2016-10-29 11:18 GMT+03:00 Marcin Domański <notifications@github.com>:

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

--
Application Developer

kabturek, 2016-10-30:
Yeah, thats a problem but you version is already here so people already use it - i havent used it yet - does it work the same as la forge fav system?

There is a lot of fixes/changes floating for rx5808 but most are not merged to the base repo and thats a shame. He wrote on rcgroups that he will accept PRs (but my 3 PRs are hanging there for 2 weeks - i hope he just doesnt have time to review them).
here is a similar  ['filter system' ](https://github.com/aschwartzmann/rx5808-pro-diversity/commit/b90b189f3a23c8496fcbe22a5a7e76c6a8a3d64b) , there are some hardware fixes (4066 isnt really great for video switching), some refactorings (memory optimisations) but none are merged back.

I have some DIY receivers myself (one with tvout and one with oled) so would be happy to add favourites to the tvout version too.

gc9n, 2016-10-30:
i made this lite cleaner version for RealAccc module for personal use .
i propably add some new features that defenetly wont go to the base repo, this current version dont have tv out , we doint need it to realacc module

kabturek, 2016-10-31:
Yep i understand the purpose.
can i port these features to the original code ?

gc9n, 2016-10-31:
Why not

On Oct 31, 2016 11:12 AM, "Marcin Domański" <notifications@github.com>
wrote:

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

robert-hoffmann, 2016-12-16:
Would be nice to share this with realacc too.
Also who cares if you merge it and the/a commercial versiont. At least many more ppl will be able benefit from all these nice features much quicker in the FPV world, and most ppl are not gonna launch themselves into a electronics project anyways.

Anyways ..great work there !

Closed 2016-10-31.

Thread 4 (2016-12-06):

Documentation needed

andmiller, 2016-12-06:
Is there any documentation we can add on new feature usage, module modification to use Fatshark buttons? Great work.

gc9n, 2016-12-06:
i am working on it , i just thinking if i will make them work only in one direction , this requires only one wire to solder, So if you push up or down in fatsharks button will go only up infinity , but if you want up down direction you have to solder 3 wires . and you have also the problem that you have to go 8 times up and 8 times down.

andmiller, 2016-12-08:
Up/Down would be better I think because you'd be able to count the channel numbers by button pushes like you can do currently with the stock modules.

Closed 2016-12-11.

Thread 7 (2016-12-19):

Separate battery needed ?

robert-hoffmann, 2016-12-19:
I couldn't quite tell from the tutorial on OscarLiangs site if you need a separate battery ..it says the internal regulator is not enough (_We have to power both the MinimOSD + diversity module with a separate power source_).

From the schema it seems like it's just piggy-backing off the power from the ventilator and using the same battery as the goggle uses (just splitting the power off the balance lead into Y between the ventilator, and the module) ..is this right ?

gc9n, 2016-12-19:
Exactly . the same battery , deferent path.
The 5V that comes from the goggles into the module are < 400mha propably the internal regulator used elsewhere  also.
So the battery its  the same , but we use a defernt regulator to power up the module+osd.

robert-hoffmann, 2016-12-20:
Thanks

Closed 2016-12-20.

Thread 8 (2016-12-20):

tantalum capacitor

Freakshowdevil, 2016-12-20:
Shouldn't the tantalum capacitor be solder to output and ground, not input and ground as you did. The document on L4941BDT
[l4941-973941.pdf](https://github.com/gc9n/rx5808-Diversity-RealAcc-Compatible/files/664876/l4941-973941.pdf)
What I can see tantalum should be solder to output

gc9n, 2016-12-20:
You can do it like this yes, i made the oposite because i saw a finished circuit with this regulator and it was like i did it. But you can do it like datasheet says

Freakshowdevil, 2016-12-20:
Okey
Do you know what size on the ceramic capacitor you used, does it matter? I have a 4.7 microF tantalum and 22 nanoF ceramic or 2.2microF ceramic, which ceramic should I use?

gc9n, 2016-12-21:
i dont really know what are the specs from the Ceramic , i know that the ceramic can handle lots of volts.
so i just picked the right size (physical dimensions)  for me.
pick the one that can handle the most

gc9n, 2016-12-21:
I am also working on the cables, i made it as clear as possible, the osd will be plug in and out for firmware updates, i will report soon with pics

robert-hoffmann, 2016-12-22:
the datasheet says 1 ceramic 0.1µf on the in pin & 1 electrolyte 22µf on the out pin

gc9n, 2016-12-22:
no problem ,
i just followed this circuit.
https://static.rcgroups.net/forums/attachments/1/7/2/2/3/6/a4459750-142-IMG_6203.jpg
as you can see the input is not a tantalum

Freakshowdevil, 2016-12-22:
On that picture the tantalum is on the input pin, both regulators are connected to it. Data sheet says tantalum on output pin so I did it that way but  My sma connector is getting really hot like really hot, so I desoldered the regulator and restored the original 5v from goggles and the heat is gone. Maybe the tantalum should be on input pin?

robert-hoffmann, 2016-12-22:
@Freakshowdevil what do you mean your SMA connector is getting hot ? How did you power it ?

Freakshowdevil, 2016-12-22:
The sma connector on the module is getting hot, barely touchable. I am powering it with L4941BDT same as gc9n.

gc9n, 2016-12-22:
you open the goggles and you replace the reg inside?

gc9n, 2016-12-22:
What goggles do you have and what is the reg inside them?

Freakshowdevil, 2016-12-22:
No, I moded exactly as u did, using a L4941BDT on the realacc module. Dominator HD v2 never opened it up so can't say what regulator is inside.
When I discovered that the sma was burning hot I striped all mods (L4941BDT and osd) and restored realacc to original.

Freakshowdevil, 2016-12-22:
By sma connector I mean antenna connector

gc9n, 2016-12-22:
Now i get it, no mine is cold, ambient temp, both sma.lets take it from start ,
what baytery did you use?
Did you connected to goggles?
Did you cut the vcc pin?
Any short circuits?

Freakshowdevil, 2016-12-22:
Using standard battery, Vcc pin cut, did exactly as you expect that my Realacc is the split version and tantalum on output pin. No pictures, the realacc is restored to original and now it's not hot anymore, will do the mod again starting with the regulator and tantalum on input pin instead to see if that makes any difference. Maybe one of my cap was too small, should be nice to know the size of your cap (the ceramic)

gc9n, 2016-12-22:
dont worry about the ceramic. the other is important.

Freakshowdevil, 2016-12-22:
Maybe it is potential different on the negative side that is the problem. My guess is that the problem lays with the caps but can't get my head around why only that long SMA "antenna" connector got heated up and nothing else, but potential different can do that hmmmmm.  Will do some more testing after Xmas.

Freakshowdevil, 2016-12-22:
A side note on OSD, rssi was visual on OSD but not the battery voltage and the fatshark buttons didn't work either. Maybe I did some thing wrong when setting minimosd up, following oscarliangs tutorial.

Freakshowdevil, 2016-12-22:
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
Your cable schematic and the pic on how you did it, pins on minimosd are not same!! Maybe it's why mine didn't work properly, I followed the schematic. What I can see is that on the schematic you're using small pad to the left of the 5v pad but on the pic on how you did it you're using the small pad where the 0 mark is on the atmega chip

gc9n, 2016-12-22:
YES You are correct
i made this mistake
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

gc9n, 2016-12-23:
This mistake, is the reason for Buttons response from fatsharks, and Battery feedback.

robert-hoffmann, 2016-12-23:
Nice clean cabling of the minim there :-)

Freakshowdevil, 2016-12-28:
Nope still no battery indication on OSD and Fatshark buttons don't work. RSSI works and the heat is gone, did put a bigger cap.
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

gc9n, 2016-12-28:
the connections  are correct
the software is the latest? for both module and osd?

gc9n, 2016-12-28:
the rssi you is changing values (is alive?)

Freakshowdevil, 2016-12-28:
Yeah everything downloaded today, yes rssi is changing value when I hold my hand in front of the antenna. No battery goggles showing up on OSD like in your video.

gc9n, 2016-12-28:
can you measure voltage in batt1  pin and ground?

Freakshowdevil, 2016-12-28:
7.66V batt1 and ground

gc9n, 2016-12-28:
if i told you that i downloaded the hex files.
and it was not working to me either!!, buttons and rssi

i uploaded a wrong version of OSD..  HOLD ON....

gc9n, 2016-12-28:
ok
i re upload the final version, please check now
https://github.com/gc9n/rx5808-Diversity-RealAcc-Compatible/blob/master/PolyPhemus.ino.hex

Freakshowdevil, 2016-12-28:
No problem mate, shit happens 😂
I will try in a bit

Freakshowdevil, 2016-12-28:
Rssi, fatshark buttons and battery osd works like a charm mate. Great work

gc9n, 2016-12-28:
ahhhh i am happier from you!

Freakshowdevil, 2016-12-28:
Only one thing with osd that I noticed was that not all of the text in under menu's don't appear as they do on the oled

gc9n, 2016-12-28:
I know . I didnt add the find model yet!

gc9n, 2016-12-28:
now make a review!

Closed 2016-12-28.

Thread 10 (2016-12-23):

Manual set freq by MHz

ethomas997, 2016-12-23:
Great work on this fork, GC9N (and, of course, upstream authors).

I think it would be quite useful to have a mode where the frequency could be dialed in manually, using the buttons to set it as a value in MHz (even if the value is not one of the current 48 channels).  I know it would require some work in the code because things operate now by frequency-index values.  Is there any interest in doing this?

--ET

gc9n, 2016-12-23:
Yes i will do it , i have it in my plans. ! (fine tuning)

Thread 11 (2016-12-31):

Micro minimosd v2

Freakshowdevil, 2016-12-31:
Can't get it to work with this one http://buzzhobbies.com.au/index.php?route=product/product&product_id=1094

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

gc9n, 2017-01-01:
Happy new year!
I used the microminim osd from banggood, this the v2 i guess,

gc9n, 2017-01-01:
tell me what exactly happen.
i remember we make it work right? now whats wrong?

gc9n, 2017-01-01:
Upload the fonts from my repository with mwosd

Freakshowdevil, 2017-01-01:
Yeah I'am doing that, but with no luck. its like fonts will not be stored

Freakshowdevil, 2017-01-01:
Now OSD menu, fatshark buttons, Rssi working, but no vbat is showing only the small goggles no battery. Don't now what was the problem but flashed every thing again.

gc9n, 2017-01-01:
you have to upload the mwosd hex into the minimosd first, you did this right?
Only with thw mwosd sketch , you can upload fonts from the mwosd wind0ws program

Freakshowdevil, 2017-01-01:
Yeah I know how to do! Found the problem with vbat, on minimosd V2 it is vbat2 instead of vbat1. Everything works now I think 😆

gc9n, 2017-01-01:
Super

Freakshowdevil, 2017-01-01:
Now with vbat2 the little battery is showing and it's half at 7,66v

gc9n, 2017-01-01:
Show me some pics, id like to see!come on

Freakshowdevil, 2017-01-01:
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

Micro minimosd V2

Freakshowdevil, 2017-01-01:
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

Freakshowdevil, 2017-01-03:
I'm still having this F..ing heat problem.  hmmm maybe that's normal due to we are using a linear regulator. At full battery the voltage drop over the regulator is 3.4volts and the module is pulling say minimum 300mA, so 1W in heat that's going to be transferred to the board and in my case the sma connector. And the L4941 DPAK has a thermal resistance of 100C/W so it's not wonder that the connector gets hot :)

brkdwn, 2017-02-10:
@Freakshowdevil is that the split diversity version ?

Freakshowdevil, 2017-02-10:
Yes that's the split version but didn't cut any trace, you see the two white cables that's video. I just removed the pin and soldered a cable between pin hole (video out on module) to osd video in. And then a cable from osd video out with a pin in the other end that you put in the goggles pin hole.

brkdwn, 2017-02-10:
Oh I see now ! Thx for the tip !

Closed 2017-04-05.

Thread 13 (2017-02-07):

Can this project be used for non diversity use?

llambkin, 2017-02-07:
Hey gc9n,

I am using your project on a custom setup I will be using in some Fatshark Base SD goggles. I want the search function and OSD RSSI infos on my screen, but when I go to compile it with USE_DIVERSITY undefined, it kicks up a fuss and spits this up as an error in Arduino:

rx5808-pro-diversityGc9n:1463: error: 'rssiB' was not declared in this scope

       OSDParams[1] = rssiB; //rssiB; //this is  B

                      ^

rx5808-pro-diversityGc9n:1464: error: 'receiver' was not declared in this scope

       OSDParams[2] = receiver; //active_receiver; //CUrrent reciever

                      ^

exit status 1
'rssiB' was not declared in this scope

Also I have compiled it with diversity enabled, and I am getting some weird flashing on the screen when it displays the channel searching. I dont know if this is related to having diversity enabled or not.

My setup is as follows:
Arduino Nano with gc9n firmware
MinimOSD with fonts installed and Polyphemus firmware
RX5808 bare module SPI mod
At the moment, it is just hooked up on the desk until I can get it functioning correctly, then it will go in the goggles.

llambkin, 2017-02-07:
Also forgot to mention, I am not using a screen either. I was going to rely solely on the OSD to control the channels.

gc9n, 2017-02-07:
You better define USE_DIVERSITY
And then set the reciever a.  What I mean is that diversity have to be on a not on auto

llambkin, 2017-02-08:
Any idea what would cause this? It only happens after a while, not straight away.
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

gc9n, 2017-02-08:
there is a bug in auto frequensy.
ingore it

llambkin, 2017-02-08:
Awesome. Thanks for replying. I'm guessing that it is being worked on?
Trying not to sound ungrateful for your awesome work. I looove what you
have achieved with this project. I can't wait to see how much further you
can take this.

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

llambkin, 2017-02-08:
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

gc9n, 2017-02-08:
thats fuckin... great Man!! put it in a box , and your ready

llambkin, 2017-02-08:
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

gc9n, 2017-02-08:
i have those goggles also. its the RCV922

gc9n, 2017-02-08:
if i where you, i wouldnt use the Arduino NANO , but the arduino pro mini .. because is small.
and draws less current

gc9n, 2017-02-08:
put it in a nice box upon (externally) like a module

llambkin, 2017-02-08:
Yeah, I did that with my Doms, I had the Nano lying around and I thought Id make use of it.
I just had to do this when sheaivey released his code:
https://www.rcgroups.com/forums/showthread.php?2629411-Modified-Fatshark-Dominator-V2-s-with-OLED-screen
I like the stock look.

gc9n, 2017-02-08:
wow nice job man..

llambkin, 2017-02-08:
Thanks. Let me know if you are working on anything. I am more than willing to pull some stuff apart to help you with alpha testing. I quite often frequent the Betaflight slack group, testing all sorts of alpha code.

llambkin, 2017-02-08:
So.... It fits! It works ok, no Vbat, need some sleep, will tackle it tomorrow.

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

Thread 14 (2017-03-01):

fatshark hd3 channel butons not workig

matolowa, 2017-03-01:
fatshark hd3 channel butons not workig.

gc9n, 2017-03-01:
Hi I believe that you didn't even read that you have to use osd in order to use buttons. Because commands goes through it???

matolowa, 2017-03-01:
problem is i´m not use osd :),

Closed 2017-03-01.

Thread 15 (2017-03-07):

Split Receiver OSD using the cable.

CptSplard, 2017-03-07:
Hi
Thanks for the work on this, I had your FW running on my Realaccs and it was great!
I've now got a Hukiya and am investigating compatibility, but it looks like it should be good if I can figure out the joystick inputs.
I was wondering about the OSD. On a split receiver version could you hijack the video signal from the remote receiver at the wire connecting the 2, instead of modifying the receiver it's self? If you could force it to use the 2nd rx while ever there was a menu displayed there'd be no need to hack traces or cut pins and the extra power needed could be taken from closer to the lipo.

Cheers
Dean

gc9n, 2017-03-17:
unfortunately this cant be done

Closed 2017-03-17.

Thread 16 (2017-03-20):

Channel, frequency limitation - can u help me ?

C3TAX, 2017-03-20:
Hi, first thanks for the great implementation, works really great. Thank you!
I would be glad about some help and hope that I am here on the right away.
I try to restrict the band, that is, I want only Raceband, LowRaceband and Fatshark, as a selection. The background is that in our team we actually only raceband fly and which are allowed in our country only. I have a little idea of Arduino programming, which is why I am dealing with it straight.
I do not want to publish it, but really only for our small team.
I have already the band, frequencies and the channels auscomommen, but apparently is not enough. Can you tell me, where I have something to comment on or have to change?

I will send you my modified code, so you can look up there maybe.

Thank you for your help.

greeting
Stefan

PS: If this is not the right way, please tell me how I can connect with you differently. Many Thanks.

gc9n, 2017-03-20:
you have to comment out  the bands you dont want from those 3 tables

// Channels to sent to the SPI registers
const uint16_t channelTable[] PROGMEM = {
  // Channel 1 - 8
  0x2A05,    0x299B,    0x2991,    0x2987,    0x291D,    0x2913,    0x2909,    0x289F,    // Band A
  0x2903,    0x290C,    0x2916,    0x291F,    0x2989,    0x2992,    0x299C,    0x2A05,    // Band B
  0x2895,    0x288B,    0x2881,    0x2817,    0x2A0F,    0x2A19,    0x2A83,    0x2A8D,    // Band E
  0x2906,    0x2910,    0x291A,    0x2984,    0x298E,    0x2998,    0x2A02,    0x2A0C,    // Band F / Airwave
#ifdef USE_LBAND
  0x281d ,   0x2890 ,   0x2902 ,   0x2915 ,   0x2987 ,   0x299a ,  0x2a0c ,    0x2a1f,    // Band C / Immersion Raceband
  0x2609,    0x261C,    0x268E,    0x2701,    0x2713,    0x2786,    0x2798,    0x280B     // Band D / 5.3
#else
  0x281d ,   0x2890 ,   0x2902 ,   0x2915 ,   0x2987 ,   0x299a ,  0x2a0c ,    0x2a1f,    // Band C / Immersion Raceband
#endif
};

// Channels with their Mhz Values
const uint16_t channelFreqTable[] PROGMEM = {
  // Channel 1 - 8
  5865, 5845, 5825, 5805, 5785, 5765, 5745, 5725, // Band A
  5733, 5752, 5771, 5790, 5809, 5828, 5847, 5866, // Band B
  5705, 5685, 5665, 5645, 5885, 5905, 5925, 5945, // Band E
  5740, 5760, 5780, 5800, 5820, 5840, 5860, 5880, // Band F / Airwave
#ifdef USE_LBAND
  5658, 5695, 5732, 5769, 5806, 5843, 5880, 5917, // Band C / Immersion Raceband
  5362, 5399, 5436, 5473, 5510, 5547, 5584, 5621  // Band D / 5.3
#else
  5658, 5695, 5732, 5769, 5806, 5843, 5880, 5917  // Band C / Immersion Raceband
#endif
};

// do coding as simple hex value to save memory.
const uint8_t channelNames[] PROGMEM = {
  0xA1, 0xA2, 0xA3, 0xA4, 0xA5, 0xA6, 0xA7, 0xA8, // Band A
  0xB1, 0xB2, 0xB3, 0xB4, 0xB5, 0xB6, 0xB7, 0xB8, // Band B
  0xE1, 0xE2, 0xE3, 0xE4, 0xE5, 0xE6, 0xE7, 0xE8, // Band E
  0xF1, 0xF2, 0xF3, 0xF4, 0xF5, 0xF6, 0xF7, 0xF8, // Band F / Airwave
#ifdef USE_LBAND
  0xC1, 0xC2, 0xC3, 0xC4, 0xC5, 0xC6, 0xC7, 0xC8, // Band C / Immersion Raceband
  0xD1, 0xD2, 0xD3, 0xD4, 0xD5, 0xD6, 0xD7, 0xD8  // BAND D / 5.3
#else
  0xC1, 0xC2, 0xC3, 0xC4, 0xC5, 0xC6, 0xC7, 0xC8  // Band C / Immersion Raceband
#endif

C3TAX, 2017-03-20:
Hi, many thanks.
But that was exactly what I had done, but unfortunately without success.
In manual mode, channels are missing or not displayed and bands A, B and E still appear during scanning.

// Channels to sent to the SPI registers
const uint16_t channelTable[] PROGMEM = {
  // Channel 1 - 8
//  0x2A05,    0x299B,    0x2991,    0x2987,    0x291D,    0x2913,    0x2909,    0x289F,    // Band A
//  0x2903,    0x290C,    0x2916,    0x291F,    0x2989,    0x2992,    0x299C,    0x2A05,    // Band B
//  0x2895,    0x288B,    0x2881,    0x2817,    0x2A0F,    0x2A19,    0x2A83,    0x2A8D,    // Band E
  0x2906,    0x2910,    0x291A,    0x2984,    0x298E,    0x2998,    0x2A02,    0x2A0C,    // Band F / Airwave
#ifdef USE_LBAND
  0x281d ,   0x2890 ,   0x2902 ,   0x2915 ,   0x2987 ,   0x299a ,  0x2a0c ,    0x2a1f,    // Band C / Immersion Raceband
  0x2609,    0x261C,    0x268E,    0x2701,    0x2713,    0x2786,    0x2798,    0x280B     // Band D / 5.3
#else
  0x281d ,   0x2890 ,   0x2902 ,   0x2915 ,   0x2987 ,   0x299a ,  0x2a0c ,    0x2a1f,    // Band C / Immersion Raceband
#endif
};

// Channels with their Mhz Values
const uint16_t channelFreqTable[] PROGMEM = {
  // Channel 1 - 8
//  5865, 5845, 5825, 5805, 5785, 5765, 5745, 5725, // Band A
//  5733, 5752, 5771, 5790, 5809, 5828, 5847, 5866, // Band B
//  5705, 5685, 5665, 5645, 5885, 5905, 5925, 5945, // Band E
  5740, 5760, 5780, 5800, 5820, 5840, 5860, 5880, // Band F / Airwave
#ifdef USE_LBAND
  5658, 5695, 5732, 5769, 5806, 5843, 5880, 5917, // Band C / Immersion Raceband
  5362, 5399, 5436, 5473, 5510, 5547, 5584, 5621  // Band D / 5.3
#else
  5658, 5695, 5732, 5769, 5806, 5843, 5880, 5917  // Band C / Immersion Raceband
#endif
};

// do coding as simple hex value to save memory.
const uint8_t channelNames[] PROGMEM = {
//  0xA1, 0xA2, 0xA3, 0xA4, 0xA5, 0xA6, 0xA7, 0xA8, // Band A
//  0xB1, 0xB2, 0xB3, 0xB4, 0xB5, 0xB6, 0xB7, 0xB8, // Band B
//  0xE1, 0xE2, 0xE3, 0xE4, 0xE5, 0xE6, 0xE7, 0xE8, // Band E
  0xF1, 0xF2, 0xF3, 0xF4, 0xF5, 0xF6, 0xF7, 0xF8, // Band F / Airwave
#ifdef USE_LBAND
  0xC1, 0xC2, 0xC3, 0xC4, 0xC5, 0xC6, 0xC7, 0xC8, // Band C / Immersion Raceband
  0xD1, 0xD2, 0xD3, 0xD4, 0xD5, 0xD6, 0xD7, 0xD8  // BAND D / 5.3
#else
  0xC1, 0xC2, 0xC3, 0xC4, 0xC5, 0xC6, 0xC7, 0xC8  // Band C / Immersion Raceband
#endif
};

gc9n, 2017-03-20:
ok
after that you have to continue with the file oled_12x64_adafruit_screes.cpp
and the in this procedure change all the For example    (if (channelIndex > 39)) LBAND have to be change with the new less bands table to say 20 . if you get what i talking about ......

void screens::updateSeekMode(uint8_t state, uint8_t channelIndex, uint8_t channel, uint8_t rssi, uint16_t channelFrequency, uint8_t rssi_seek_threshold, bool locked) {
  // display refresh handler
  if (channel != last_channel) // only updated on changes
  {
    if (channel > last_channel) {
      scan_position = 3;
    }
    else {
      scan_position = -1;
    }
    display.setTextColor(WHITE, BLACK);
    display.setCursor(36, 12);
    // show current used channel of bank
#ifdef USE_LBAND
    if (channelIndex > 39)
    {
      display.print(PSTR2("D/5.3    "));
    }
    else if (channelIndex > 31)
#else
    if (channelIndex > 31)
#endif
    {
      display.print(PSTR2("C/Race   "));
    }
    else if (channelIndex > 23)
    {
      display.print(PSTR2("F/Airwave"));
    }
    else if (channelIndex > 15)
    {
      display.print(PSTR2("E        "));
    }
    else if (channelIndex > 7)
    {
      display.print(PSTR2("B        "));
    }
    else
    {
      display.print(PSTR2("A        "));
    }

    uint8_t active_channel = channelIndex % CHANNEL_BAND_SIZE; // get channel inside band
    for (int i = 0; i < 8; i++) {
      display.fillRect(15 * i + 4, 21, 14, 11, i == active_channel ? WHITE : BLACK);
      display.setTextColor(i == active_channel ? BLACK : WHITE);
      display.setCursor(15 * i + 8, 23);
      display.print((char) (i + '1'));
    }

    // show frequence
    display.setCursor(101, 12);
    display.setTextColor(WHITE, BLACK);
    display.print(channelFrequency);
  }
  // show signal strength
  uint8_t rssi_scaled = map(rssi, 1, 100, 1, display.width() - 3);

  display.fillRect(1 + rssi_scaled, 33, display.width() - 3 - rssi_scaled, 3, BLACK);
  display.fillRect(1, 33, rssi_scaled, 3, WHITE);

  rssi_scaled = map(rssi, 1, 100, 1, 14);
#ifdef USE_LBAND
  display.fillRect((channel * 3) + 4, display.height() - 12 - 14, 5 / 2, 14 - rssi_scaled, BLACK);
  display.fillRect((channel * 3) + 4, (display.height() - 12 - rssi_scaled), 5 / 2, rssi_scaled, WHITE);
#else
  display.fillRect((channel * 3) + 4, display.height() - 12 - 14, 3, 14 - rssi_scaled, BLACK);
  display.fillRect((channel * 3) + 4, (display.height() - 12 - rssi_scaled), 3, rssi_scaled, WHITE);
#endif

  // handling for seek mode after screen and RSSI has been fully processed
  if (state == STATE_SEEK) //
  { // SEEK MODE

    // Show Scan Position
#ifdef USE_LBAND
    display.fillRect((channel * 5 / 2) + 4 + scan_position, display.height() - 12 - 14, 1, 14, BLACK);
#else
    display.fillRect((channel * 3) + 4 + scan_position, display.height() - 12 - 14, 1, 14, BLACK);
#endif

    rssi_scaled = map(rssi_seek_threshold, 1, 100, 1, 14);

    display.fillRect(1, display.height() - 12 - 14, 2, 14, BLACK);
    display.drawLine(1, display.height() - 12 - rssi_scaled, 2, display.height() - 12 - rssi_scaled, WHITE);
    display.fillRect(display.width() - 3, display.height() - 12 - 14, 2, 14, BLACK);
    display.drawLine(display.width() - 3, display.height() - 12 - rssi_scaled, display.width(), display.height() - 12 - rssi_scaled, WHITE);

    if (locked) // search if not found
    {
      display.setTextColor(BLACK, WHITE);
      display.setCursor(((display.width() - 14 * 6) / 2), 2);
      display.print(PSTR2("AUTO MODE LOCK"));
    }
    else
    {
      display.setTextColor(BLACK, WHITE);
      display.setCursor(((display.width() - 14 * 6) / 2), 2);
      display.print(PSTR2("AUTO SEEK MODE"));
    }
  }

  last_channel = channel;
  display.display();
}

Thread 17 (2017-04-03):

Ordering bug in 'channelList[]'

ethomas997, 2017-04-03:
Don't know how much it affects things, but in the list of indices for the 'channelList[]' array ("channels ordered by Mhz"), the values 18 and 32 should be swapped.  Currently the order is:

`19, 18, 32, ...`

it should be:

`19, 32, 18, ...`

19 => 5645
18 => 5665
32 => 5658

--ET

Thread 24 (2017-05-10):

New files and new options - Infos ?

brkdwn, 2017-05-10:
Hi @gc9n ,

Since your new video yesterday I looked back at your github account, and faund you recently made changes and additions. So I reflashed my minim osd and my RX5808 with:

**PolyPhemus.ino.hex** and **rx5808-pro-diversityGc9n.ino.hex**

I used the eeprom_clear.ino.hex before uploading. It works, no problem. But it seems the old antenna icons and tension are gone ?

Also would explain a little bit what is:  **DIV/TY Collector 0-20** ?

And may be a word about:  **Gc9n_rx5808_WhiteLess.hex**

Thanks again for your work !

Ben - brkdwn
