gc9n/rx5808-Diversity-RealAcc-Compatible/rx5808-pro-diversityGc9n/rx5808-pro-diversityGc9n.ino

/*
* SPI driver based on fs_skyrf_58g-main.c Written by Simon Chambers
* TVOUT by Myles Metzel
* Scanner by Johan Hermen
* Inital 2 Button version by Peter (pete1990)
* Refactored and GUI reworked by Marko Hoepken
* Universal version my Marko Hoepken
* Diversity Receiver Mode and GUI improvements by Shea Ivey
* OLED Version by Shea Ivey
* Seperating display concerns by Shea Ivey
* 10 Favorite channels and functionality by George Chatzisavvidis
* change in displays by George Chatzisavvidis
* Adding Fatshark button to work with the module by George Chatzisavvidis
* OSD SUPPORT George Chatzisavvidis
*
* The MIT License (MIT)
*
* Copyright (c) 2015 Marko Hoepken
*
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
* THE SOFTWARE IS PROVIDED "AS IS", WITHOUT WARRANTY OF ANY KIND, EXPRESS OR
* IMPLIED, INCLUDING BUT NOT LIMITED TO THE WARRANTIES OF MERCHANTABILITY,
* FITNESS FOR A PARTICULAR PURPOSE AND NONINFRINGEMENT. IN NO EVENT SHALL THE
* AUTHORS OR COPYRIGHT HOLDERS BE LIABLE FOR ANY CLAIM, DAMAGES OR OTHER
* LIABILITY, WHETHER IN AN ACTION OF CONTRACT, TORT OR OTHERWISE, ARISING FROM,
* OUT OF OR IN CONNECTION WITH THE SOFTWARE OR THE USE OR OTHER DEALINGS IN THE
* SOFTWARE.
*/

#include <avr/pgmspace.h>
#include <EEPROM.h>

#include "settings.h"

// uncomment depending on the display you are using.
// this is an issue with the arduino preprocessor

#ifdef OLED_128x64_ADAFRUIT_SCREENS

#ifdef SH1106
// #include <Adafruit_SH1106.h>
#else
#include <Adafruit_SSD1306.h>
// if you are using display SSD1306 please download the library Adafruit_SSD1306 and edit the file Adafruit_SSD1306.h - Uncomment the line:  #define SSD1306_128_64
#endif
#include <Adafruit_GFX.h>
#include <Wire.h>
#include <SPI.h>
#endif

#include "screens.h"
screens drawScreen;

#define EEPROM_ADR_TUNE_FAV_LAST 108

//setting the 10 favorite channels memory blocks George Chatzisavvidis GC9N
int EEPROM_ADR_TUNE_FAV[10] = { 100, 101, 102, 103, 104, 105, 106, 107, 110, 111 };
int temp_EEPROM_ADR_TUNE_FAV[10] = { 255, 255, 255, 255, 255, 255, 255, 255, 255, 255 };

int OSDParams[4] = { 0, 3, 0, 0 };
char OSDCommand[18] = " DRAWMENU";

// Channels to sent to the SPI registers
const uint16_t channelTable[] PROGMEM = {
	// Channel 1 - 8
	0x2A05, 0x299B, 0x2991, 0x2987, 0x291D, 0x2913, 0x2909, 0x289F,                         // Band A
	0x2903, 0x290C, 0x2916, 0x291F, 0x2989, 0x2992, 0x299C, 0x2A05,                         // Band B
	0x2895, 0x288B, 0x2881, 0x2817, 0x2A0F, 0x2A19, 0x2A83, 0x2A8D,                         // Band E
	0x2906, 0x2910, 0x291A, 0x2984, 0x298E, 0x2998, 0x2A02, 0x2A0C,                         // Band F / Airwave
#ifdef USE_LBAND
	0x281d, 0x2890, 0x2902, 0x2915, 0x2987, 0x299a, 0x2a0c, 0x2a1f,                         // Band C / Immersion Raceband
	0x2609, 0x261C, 0x268E, 0x2701, 0x2713, 0x2786, 0x2798, 0x280B                          // Band D / 5.3
#else
	0x281d, 0x2890, 0x2902, 0x2915, 0x2987, 0x299a, 0x2a0c, 0x2a1f,                         // Band C / Immersion Raceband
#endif
};

// Channels with their Mhz Values
const uint16_t channelFreqTable[] PROGMEM = {
	// Channel 1 - 8
	5865, 5845, 5825, 5805, 5785, 5765, 5745, 5725, // Band A
	5733, 5752, 5771, 5790, 5809, 5828, 5847, 5866, // Band B
	5705, 5685, 5665, 5645, 5885, 5905, 5925, 5945, // Band E
	5740, 5760, 5780, 5800, 5820, 5840, 5860, 5880, // Band F / Airwave
#ifdef USE_LBAND
	5658, 5695, 5732, 5769, 5806, 5843, 5880, 5917, // Band C / Immersion Raceband
	5362, 5399, 5436, 5473, 5510, 5547, 5584, 5621  // Band D / 5.3
#else
	5658, 5695, 5732, 5769, 5806, 5843, 5880, 5917  // Band C / Immersion Raceband
#endif
};

// do coding as simple hex value to save memory.
const uint8_t channelNames[] PROGMEM = {
	0xA1, 0xA2, 0xA3, 0xA4, 0xA5, 0xA6, 0xA7, 0xA8, // Band A
	0xB1, 0xB2, 0xB3, 0xB4, 0xB5, 0xB6, 0xB7, 0xB8, // Band B
	0xE1, 0xE2, 0xE3, 0xE4, 0xE5, 0xE6, 0xE7, 0xE8, // Band E
	0xF1, 0xF2, 0xF3, 0xF4, 0xF5, 0xF6, 0xF7, 0xF8, // Band F / Airwave
#ifdef USE_LBAND
	0xC1, 0xC2, 0xC3, 0xC4, 0xC5, 0xC6, 0xC7, 0xC8, // Band C / Immersion Raceband
	0xD1, 0xD2, 0xD3, 0xD4, 0xD5, 0xD6, 0xD7, 0xD8  // BAND D / 5.3
#else
	0xC1, 0xC2, 0xC3, 0xC4, 0xC5, 0xC6, 0xC7, 0xC8  // Band C / Immersion Raceband
#endif
};

// All Channels of the above List ordered by Mhz
const uint8_t channelList[] PROGMEM = {
#ifdef USE_LBAND
	40, 41, 42, 43, 44, 45, 46, 47, 19, 18, 32, 17, 33, 16, 7,  34, 8,  24, 6,  9,  25, 5,  35, 10, 26, 4,  11, 27, 3, 36, 12, 28, 2,  13, 29, 37, 1,  14, 30, 0, 15, 31, 38, 20, 21, 39, 22, 23
#else
	19, 18, 32, 17, 33, 16, 7,  34, 8,  24, 6,  9,  25, 5,  35, 10, 26, 4,  11, 27, 3,  36, 12, 28, 2,  13, 29, 37, 1, 14, 30, 0,  15, 31, 38, 20, 21, 39, 22, 23
#endif
};

char    channel           = 0;
uint8_t channelIndex      = 0;
uint8_t rssi              = 0;
uint8_t p_rssi            = 0;
uint8_t rssi_scaled       = 0;
uint8_t active_receiver   = useReceiverA;
uint8_t p_active_receiver = -1;

#ifdef USE_DIVERSITY
uint8_t diversity_mode        = useReceiverAuto;
char    diversity_check_count = 0;                   // used to decide when to change antennas.
#endif
uint8_t       rssi_seek_threshold = RSSI_SEEK_TRESHOLD;
uint8_t       hight               = 0;
uint8_t       state               = START_STATE;
uint8_t       state_last_used     = START_STATE;
uint8_t       last_state          = START_STATE + 1; // force screen draw
uint8_t       writePos            = 0;
uint8_t       switch_count        = 0;
uint8_t       man_channel         = 0;
uint8_t       last_channel_index  = 0;
uint8_t       force_seek          = 0;
uint8_t       seek_direction      = 1;
unsigned long time_of_tune        = 0;               // will store last time when tuner was changed
unsigned long time_screen_saver   = 0;
unsigned long time_screen_saver2  = 0;
unsigned long time_next_payload   = 0;
uint8_t       last_active_channel = 0;
uint8_t       seek_found          = 0;
uint8_t       last_dip_channel    = 255;
uint8_t       last_dip_band       = 255;
uint8_t       scan_start          = 0;
uint8_t       first_tune          = 1;
boolean       force_menu_redraw   = 0;
uint16_t      rssi_best           = 0;               // used for band scaner
uint16_t      rssi_min_a          = RSSI_MIN_VAL;
uint16_t      rssi_max_a          = RSSI_MAX_VAL;
uint16_t      rssi_setup_min_a    = RSSI_MIN_VAL;
uint16_t      rssi_setup_max_a    = RSSI_MAX_VAL;

#ifdef USE_DIVERSITY
uint16_t rssi_min_b       = RSSI_MIN_VAL;
uint16_t rssi_max_b       = RSSI_MAX_VAL;
uint16_t rssi_setup_min_b = RSSI_MIN_VAL;
uint16_t rssi_setup_max_b = RSSI_MAX_VAL;
#endif

uint8_t rssi_setup_run = 0;
char    call_sign[10];
bool    settings_beeps           = true;
bool    settings_OSD             = true;
bool    settings_orderby_channel = true;
bool    HaveFav    = false;
bool    RefreshFav = false;
uint8_t FirstFav   = 0;

//bool FATSHARK_BUTTON_PUSHED=false;
//int  LAST_FATSHARK_BUTTON_STATE=0;
int  lfavs         = 0;
byte FS_BUTTON_DIR = 0;

// ------------------------------------- SETUP ---------------------------------
void setup() {
	Serial.begin(57600);
  
	// initialize digital pin 13 LED as an output.
	pinMode(led, OUTPUT); // status pin for TV mode errors
	digitalWrite(led, HIGH);
	
	// buzzer
	pinMode(buzzer, OUTPUT); // Feedback buzzer (active buzzer, not passive piezo)
	digitalWrite(buzzer, HIGH);
	
	// minimum control pins
	pinMode(buttonUp, INPUT);
	digitalWrite(buttonUp, INPUT_PULLUP);
	pinMode(buttonMode, INPUT);
	digitalWrite(buttonMode, INPUT_PULLUP);
	
	// optional control
	pinMode(buttonDown, INPUT);
	digitalWrite(buttonDown, INPUT_PULLUP);
	pinMode(buttonSave, INPUT);
	digitalWrite(buttonSave, INPUT_PULLUP);
	
	//Receiver Setup
	pinMode(receiverA_led, OUTPUT);
#ifdef USE_DIVERSITY
	pinMode(receiverB_led, OUTPUT);
#endif
	setReceiver(useReceiverA);
	
	// SPI pins for RX control
	pinMode(slaveSelectPin, OUTPUT);
	pinMode(spiDataPin, OUTPUT);
	pinMode(spiClockPin, OUTPUT);

	// use values only of EEprom is not 255 = unsaved
	uint8_t eeprom_check = EEPROM.read(EEPROM_ADR_STATE);
	if (eeprom_check == 255) { // unused
		// save 8 bit
		EEPROM.write(EEPROM_ADR_STATE, START_STATE);
		EEPROM.write(EEPROM_ADR_TUNE, CHANNEL_MIN_INDEX);
		EEPROM.write(EEPROM_ADR_BEEP, settings_beeps);
		EEPROM.write(EEPROM_ADR_OSD, settings_OSD);
		EEPROM.write(EEPROM_ADR_ORDERBY, settings_orderby_channel);
	
		// save 16 bit
		EEPROM.write(EEPROM_ADR_RSSI_MIN_A_L, lowByte(RSSI_MIN_VAL));
		EEPROM.write(EEPROM_ADR_RSSI_MIN_A_H, highByte(RSSI_MIN_VAL));
		
		// save 16 bit
		EEPROM.write(EEPROM_ADR_RSSI_MAX_A_L, lowByte(RSSI_MAX_VAL));
		EEPROM.write(EEPROM_ADR_RSSI_MAX_A_H, highByte(RSSI_MAX_VAL));

		// save default call sign
		strcpy(call_sign, CALL_SIGN); // load callsign
		for (uint8_t i = 0; i < sizeof(call_sign); i++)
		EEPROM.write(EEPROM_ADR_CALLSIGN + i, call_sign[i]);

#ifdef USE_DIVERSITY
		// diversity
		EEPROM.write(EEPROM_ADR_DIVERSITY, diversity_mode);
		
		// save 16 bit
		EEPROM.write(EEPROM_ADR_RSSI_MIN_B_L, lowByte(RSSI_MIN_VAL));
		EEPROM.write(EEPROM_ADR_RSSI_MIN_B_H, highByte(RSSI_MIN_VAL));
		
		// save 16 bit
		EEPROM.write(EEPROM_ADR_RSSI_MAX_B_L, lowByte(RSSI_MAX_VAL));
		EEPROM.write(EEPROM_ADR_RSSI_MAX_B_H, highByte(RSSI_MAX_VAL));
#endif
	}

	// read last setting from eeprom
	state = EEPROM.read(EEPROM_ADR_STATE);
	channelIndex = EEPROM.read(EEPROM_ADR_TUNE);
	
	// set the channel as soon as we can
	// faster boot up times :)
	setChannelModule(channelIndex);
	last_channel_index = channelIndex;

	settings_beeps = EEPROM.read(EEPROM_ADR_BEEP);
	settings_OSD = EEPROM.read(EEPROM_ADR_OSD);

	settings_orderby_channel = EEPROM.read(EEPROM_ADR_ORDERBY);

	// load saved call sign
	for (uint8_t i = 0; i < sizeof(call_sign); i++)
	  call_sign[i] = EEPROM.read(EEPROM_ADR_CALLSIGN + i);

	rssi_min_a = ((EEPROM.read(EEPROM_ADR_RSSI_MIN_A_H) << 8) | (EEPROM.read(EEPROM_ADR_RSSI_MIN_A_L)));
	rssi_max_a = ((EEPROM.read(EEPROM_ADR_RSSI_MAX_A_H) << 8) | (EEPROM.read(EEPROM_ADR_RSSI_MAX_A_L)));
  
#ifdef USE_DIVERSITY
	diversity_mode = EEPROM.read(EEPROM_ADR_DIVERSITY);
	rssi_min_b = ((EEPROM.read(EEPROM_ADR_RSSI_MIN_B_H) << 8) | (EEPROM.read(EEPROM_ADR_RSSI_MIN_B_L)));
	rssi_max_b = ((EEPROM.read(EEPROM_ADR_RSSI_MAX_B_H) << 8) | (EEPROM.read(EEPROM_ADR_RSSI_MAX_B_L)));
#endif

	force_menu_redraw = 1;

	// Init Display
	if (drawScreen.begin(call_sign) > 0) {
		// on Error flicker LED
		while (true) { // stay in ERROR for ever
			digitalWrite(led, !digitalRead(led));
			delay(100);
		}
	}

#ifdef USE_DIVERSITY
	// make sure we use receiver Auto when diveristy is unplugged.
	if (!isDiversity())	diversity_mode = useReceiverAuto;

#endif
	// Setup Done - Turn Status LED off.
	digitalWrite(led, LOW);
}


// ----------------------------------- LOOP -----------------------------------------
void loop() {
	/*******************/
	/*   Mode Select   */
	/*******************/

	uint8_t in_menu;
	uint8_t in_menu_time_out;

	if (digitalRead(buttonMode) == LOW) { // key pressed ?
		//Serial.println("kei");

		time_screen_saver = 0;
		beep(50);                       // beep & debounce
		delay(KEY_DEBOUNCE / 2);        // debounce
		beep(50);                       // beep & debounce
		delay(KEY_DEBOUNCE / 2);        // debounce

		uint8_t press_time = 0;
   
		// on entry wait for release
		while (digitalRead(buttonMode) == LOW && press_time < 10) {
			delay(100);
			press_time++;
		}

		OSDParams[0] = 0;       //this is main menu
		OSDParams[1] = 3;       //By default goes over manual
		SendToOSD();            //UPDATE OSD

#define MAX_MENU 7
#define MENU_Y_SIZE 15

		char menu_id = 2;       //state_last_used-1;
    
		// Show Mode Screen
		if (state == STATE_SEEK_FOUND)		state = STATE_SEEK;
		in_menu = 1;
		in_menu_time_out = 50;   // 20x 100ms = 5 seconds
		/*
	* Enter Mode menu
	* Show current mode
	* Change mode by MODE key
	* Any Mode will refresh screen
	* If not MODE changes in 2 seconds, it uses last used mode
	*/
		do {
			if (press_time >= 10) {   // if menu held for 1 second invoke quick save.
		
				// user held the mode button and wants to quick save.
				in_menu = 0;            // EXIT
				state = STATE_SAVE;
				OSDParams[0] = -2;      //this is save
				SendToOSD();            //UPDATE OSD
				break;
			}

			switch (menu_id) {
			case 0:                          // AUTO MODE
				state = STATE_SEEK;
				force_seek = 1;
				seek_found = 0;
				break;
			case 1:                          // Band Scanner
				state = STATE_SCAN;
				scan_start = 1;
				break;
			case 2:                          // manual mode
				state = STATE_MANUAL;
				break;
#ifdef USE_DIVERSITY
			case 3:                          // Diversity
				if (isDiversity()) {
					state = STATE_DIVERSITY;
				} else {
					menu_id++;
					state = STATE_SETUP_MENU;
				}
				break;
#else
			case 3:                   // Skip
				menu_id++;
#endif
			case 4:                                         // Favorites Menu        //gc9n
				state = STATE_FAVORITE;                                                //gc9n
				break;                                                                 //gc9n
			case 5:                                         // Setup Menu            //gc9n
				state = STATE_SETUP_MENU;                                              //gc9n
				break;                                                                 //gc9n
			case 6:                                         // Beeps enable/disable  //gc9n
				break;                                                                 //gc9n
			case 7:                                         //Vres modelo            //gc9n
				state = STATE_SCREEN_SAVER_LITE;                                       //gc9n
				//drawScreen.updateScreenSaver(rssi);
				break;
			} // end switch

			// draw mode select screen
			////Serial.println (state);
			if (menu_id > 4) drawScreen.mainMenuSecondPage(menu_id - 5, settings_OSD);
			else drawScreen.mainMenu(menu_id);

      // wait for MODE release
			while (digitalRead(buttonMode) == LOW || digitalRead(buttonUp) == LOW || digitalRead(buttonDown) == LOW || FSButtonDirection() == 1 || FSButtonDirection() == 2)
			  in_menu_time_out = 50;


			// wait for next key press or time out
			while (--in_menu_time_out && ((digitalRead(buttonMode) == HIGH) && (digitalRead(buttonUp) == HIGH) && (digitalRead(buttonDown) == HIGH) && FSButtonDirection() == 0))
				delay(100);                                                                                                                                                     // timeout delay
				
			if (in_menu_time_out == 0 || digitalRead(buttonMode) == LOW) {
				if (menu_id == 6) {
					settings_OSD = !settings_OSD;
					EEPROM.write(EEPROM_ADR_OSD, settings_OSD);
					if (settings_OSD == false) {
						OSDParams[0] = -99;     // CLEAR OSD
						SendToOSD();            // UPDATE OSD
					} else {
						OSDParams[0] = 0;       // ENABLE OSD AND GO OVER MAIN MENU OSD SELECTION
						OSDParams[1] = 7;       // OSD
						SendToOSD();            // UPDATE OSD
					}
				} else {
					// Serial.read();
					if (digitalRead(buttonMode) != LOW)
			  		state = state_last_used;              // exit to last state on timeout.
					in_menu = 0;                            // EXIT
					beep(KEY_DEBOUNCE / 2);                 // beep & debounce
					delay(50);                              // debounce
					beep(KEY_DEBOUNCE / 2);                 // beep & debounce
					delay(50);                              // debounce
				}
			} else { // no timeout, must be keypressed

				/*********************/
				/*   Menu handler   */
				/*********************/
				if (digitalRead(buttonUp) == LOW || FS_BUTTON_DIR == 1) {
					menu_id--;
#ifdef USE_DIVERSITY
				if (!isDiversity() && menu_id == 3)     // make sure we back up two menu slots.
				  menu_id--;

#endif
				} else if (digitalRead(buttonDown) == LOW || FS_BUTTON_DIR == 2) {
					menu_id++;
				}

				if (menu_id > MAX_MENU)	  menu_id = 0;               // next state
				else if (menu_id < 0)	menu_id = MAX_MENU;

				in_menu_time_out = 50;
				beep(50);                       // beep & debounce
				delay(KEY_DEBOUNCE);            // debounce
				OSDParams[0] = 0;               //this is main menu
				OSDParams[1] = menu_id + 1;     //By defaut=lt goes over manual
				SendToOSD();                    //UPDATE OSD
			}
		} while (in_menu);

		last_state = 255; // force redraw of current screen
		switch_count = 0;
	} else { // key pressed
		// reset debounce
		switch_count = 0;
	}
	/***********************/
	/*     Save buttom     */
	/***********************/
	
	// hardware save buttom support (if no display is used)
	if (digitalRead(buttonSave) == LOW)
		state = STATE_SAVE;

	/***************************************/
	/*   Draw screen if mode has changed   */
	/***************************************/
	if (force_menu_redraw || state != last_state) {
		force_menu_redraw = 0;
		
		/************************/
		/*   Main screen draw   */
		/************************/
		// changed state, clear an draw new screen

		// simple menu
		switch (state) {
		case STATE_SCAN:              // Band Scanner
			state_last_used = state;
		case STATE_RSSI_SETUP:       // RSSI setup
			// draw selected
			if (state == STATE_RSSI_SETUP) {
				// prepare new setup
				rssi_min_a = 50;
				rssi_max_a = 300;        // set to max range
				rssi_setup_min_a = RSSI_MAX_VAL;
				rssi_setup_max_a = RSSI_MIN_VAL;
#ifdef USE_DIVERSITY
				rssi_min_b = 50;
				rssi_max_b = 300;         // set to max range
				rssi_setup_min_b = RSSI_MAX_VAL;
				rssi_setup_max_b = RSSI_MIN_VAL;
#endif
				rssi_setup_run = RSSI_SETUP_RUN;
			}

			// trigger new scan from begin
			channel = CHANNEL_MIN;
			channelIndex = pgm_read_byte_near(channelList + channel);
			rssi_best = 0;
			scan_start = 1;
			drawScreen.bandScanMode(state);
			break;
		case STATE_SEEK: // seek mode
			rssi_seek_threshold = RSSI_SEEK_TRESHOLD;
			rssi_best = 0;
			force_seek = 1;
		case STATE_MANUAL: // manual mode
			if (state == STATE_MANUAL)
			time_screen_saver = millis();
			else if (state == STATE_SEEK)
			time_screen_saver = 0;                     // dont show screen saver until we found a channel.
			drawScreen.seekMode(state);

			// return user to their saved channel after bandscan
			if (state_last_used == STATE_SCAN || state_last_used == STATE_FAVORITE || last_state == STATE_RSSI_SETUP)
			channelIndex = EEPROM.read(EEPROM_ADR_TUNE);
			state_last_used = state;
			break;
#ifdef USE_DIVERSITY
		case STATE_DIVERSITY:
			
			// diversity menu is below this is just a place holder.
			break;
#endif
		case STATE_SETUP_MENU:
			break;
		case STATE_SAVE:

			EEPROM.write(EEPROM_ADR_TUNE, channelIndex);
			EEPROM.write(EEPROM_ADR_STATE, state_last_used);
			EEPROM.write(EEPROM_ADR_BEEP, settings_beeps);
			EEPROM.write(EEPROM_ADR_ORDERBY, settings_orderby_channel);
			
			// save call sign
			for (uint8_t i = 0; i < sizeof(call_sign); i++)
			EEPROM.write(EEPROM_ADR_CALLSIGN + i, call_sign[i]);

#ifdef USE_DIVERSITY
			EEPROM.write(EEPROM_ADR_DIVERSITY, diversity_mode);
#endif

			// FAVORITIES SAVE Gc9n
			if (last_state != STATE_SETUP_MENU && state_last_used != STATE_FAVORITE) {     // if you didnt came from menu setup  save favorite
				if (EEPROM.read(EEPROM_ADR_TUNE_FAV[9]) != 255) { //ALL FAVS full gc9n
					int lfav;
					lfav = EEPROM.read(EEPROM_ADR_TUNE_FAV_LAST);
					if (lfav == 9)
					lfav = 0;
					else
					lfav = lfav + 1;
					EEPROM.write(EEPROM_ADR_TUNE_FAV[lfav], 255);           // rotate the favs if full
					EEPROM.write(EEPROM_ADR_TUNE_FAV_LAST, lfav);
				}
       
				for (int i = 0; i < 10; i++) {
					if (EEPROM.read(EEPROM_ADR_TUNE_FAV[i]) == 255) {       //not used  gc9n
						EEPROM.write(EEPROM_ADR_TUNE_FAV[i], channelIndex);
						EEPROM.write(EEPROM_ADR_TUNE_FAV_LAST, i);
						i = 12; //exit loop
					}
				}
				OSDParams[0] = -2;      //this is save
				OSDParams[1] = 0;       //By default goes over manual
				SendToOSD();            //UPDATE OSD
				drawScreen.save(state_last_used, channelIndex, pgm_read_word_near(channelFreqTable + channelIndex), call_sign, EEPROM.read(EEPROM_ADR_TUNE_FAV_LAST) + 1);
			}
			if (last_state == STATE_SETUP_MENU) {
				OSDParams[0] = -2;      //this is save
				OSDParams[1] = 0;       //By default goes over manual
				SendToOSD();            //UPDATE OSD
				drawScreen.save(state_last_used, channelIndex, pgm_read_word_near(channelFreqTable + channelIndex), call_sign, -99);
			}

			///LONG PRESS IN FAVORITES WILL DELETE THE CURRENT FAVORITE CHANNEL
			if (state_last_used == STATE_FAVORITE && last_state == 255) {
				OSDParams[0] = -3;      //this is delete
				OSDParams[1] = 0;       //By default goes over manual
				SendToOSD();            //UPDATE OSD
				EEPROM.write(EEPROM_ADR_TUNE_FAV[lfavs], 255);
				drawScreen.FavDelete(pgm_read_word_near(channelFreqTable + channelIndex), lfavs + 1);

				for (int i = 0; i < 10; i++)
					temp_EEPROM_ADR_TUNE_FAV[i] = 255; //empty temp

				//--REORGANIZE FAVS  GC9n
				int MaxFav = 0;
				for (int i = 0; i < 10; i++) {
					if (EEPROM.read(EEPROM_ADR_TUNE_FAV[i]) != 255) { //not used  gc9n
						FillTemp_Tune_fav(EEPROM.read(EEPROM_ADR_TUNE_FAV[i]));
						MaxFav++;
					}
				}

				for (int i = 0; i < 10; i++)
					EEPROM.write(EEPROM_ADR_TUNE_FAV[i], temp_EEPROM_ADR_TUNE_FAV[i]);

				//DELETED SUCCESFULLY AND GO TO FIRST FAV (IF EXISTS)
				//drawScreen.FavReorg(MaxFav);
				RefreshFav = false;
				delay(1000);
				EEPROM.write(EEPROM_ADR_TUNE_FAV_LAST, 0);
				channelIndex = EEPROM.read(EEPROM_ADR_TUNE_FAV[0]);
				lfavs = 0;
				channelIndex = EEPROM.read(EEPROM_ADR_TUNE_FAV[0]);
				drawScreen.FavSel(1);
				channel = channel_from_index(channelIndex);
				EEPROM.write(EEPROM_ADR_TUNE, channelIndex);

				//drawScreen.screenSaver(diversity_mode, pgm_read_byte_near(channelNames + channelIndex), pgm_read_word_near(channelFreqTable + channelIndex), call_sign);
			}
			///END LONG PRESS IN FAVORITES WILL DELETE THE CURRENT FAVORITE CHANNEL
			for (uint8_t loop = 0; loop < 5; loop++) {
				beep(100); // beep
				delay(100);
			}
			delay(800);
			state = state_last_used;        // return to saved function
			force_menu_redraw = 1;          // we change the state twice, must force redraw of menu

			// selection by inverted box
			break;
		case STATE_FAVORITE: // FAV mode
			if (state == STATE_FAVORITE)
				time_screen_saver = millis();
			else if (state == STATE_SEEK)
				time_screen_saver = 0;        // dont show screen saver until we found a channel.

			//drawScreen.FavMode(state,FirstFav);
			// return user to their saved channel after bandscan
			if (state_last_used == STATE_SCAN || state_last_used == STATE_FAVORITE || last_state == STATE_RSSI_SETUP)
				channelIndex = EEPROM.read(EEPROM_ADR_TUNE);
			
			state_last_used = state;
			break;
		}                     // end switch

		last_state = state;
	}

	/*************************************/
	/*   Processing depending of state   */
	/*************************************/
#ifndef TVOUT_SCREENS
	if (state == STATE_SCREEN_SAVER || state == STATE_SCREEN_SAVER_LITE) {
#ifdef USE_DIVERSITY
		drawScreen.screenSaver(diversity_mode, pgm_read_byte_near(channelNames + channelIndex), pgm_read_word_near(channelFreqTable + channelIndex), call_sign);
#else
		drawScreen.screenSaver(pgm_read_byte_near(channelNames + channelIndex), pgm_read_word_near(channelFreqTable + channelIndex), call_sign);
#endif
		time_screen_saver = millis();
		do {
			rssi = readRSSI();
			if (((time_screen_saver != 0 && time_screen_saver + (SCREENSAVER_TIMEOUT * 1000) < millis()))) {
				OSDParams[0] = -99;     // CLEAR OSD
				SendToOSD();            //UPDATE OSD
				time_screen_saver = 0;
			}

#ifdef USE_DIVERSITY
			drawScreen.updateScreenSaver(active_receiver, rssi, readRSSI(useReceiverA), readRSSI(useReceiverB));
#else
			drawScreen.updateScreenSaver(rssi);
#endif
		} while ((digitalRead(buttonMode) == HIGH) && (digitalRead(buttonUp) == HIGH) && (digitalRead(buttonDown) == HIGH) && FSButtonDirection() == 0);
		// wait for next button press
		state = state_last_used;
		return;
	}
#endif

#ifdef USE_DIVERSITY
	if (state == STATE_DIVERSITY) {
		// simple menu
		char menu_id = diversity_mode;
		uint8_t in_menu = 1;
		do {
			diversity_mode = menu_id;
			drawScreen.diversity(diversity_mode);
			do {
				//delay(10); // timeout delay
				readRSSI();
				drawScreen.updateDiversity(active_receiver, readRSSI(useReceiverA), readRSSI(useReceiverB));
			} while ((digitalRead(buttonMode) == HIGH) && (digitalRead(buttonUp) == HIGH) && (digitalRead(buttonDown) == HIGH) && FSButtonDirection() == 0);        // wait for next mode or time out

			if (digitalRead(buttonMode) == LOW)                                                                                                                     // channel UP
				in_menu = 0;                                                                                                                                    // exit menu
			else if (digitalRead(buttonUp) == LOW || FS_BUTTON_DIR == 1)
				menu_id--;
			else if (digitalRead(buttonDown) == LOW || FS_BUTTON_DIR == 2)
				menu_id++;

			if (menu_id > useReceiverB)    menu_id = 0;
			else if (menu_id < 0)      menu_id = useReceiverB;
			
			beep(50);                          // beep & debounce
			delay(KEY_DEBOUNCE);              // debounce
		} while (in_menu);

		state = state_last_used;
	}
#endif
	if (state != STATE_FAVORITE)	RefreshFav = false;
	
	/*****************************************/
	/*   Processing FAVORITES                */
	/*****************************************/
	if (state == STATE_FAVORITE) { //|| state == STATE_SEEK)
		// read rssi
		wait_rssi_ready();
		rssi = readRSSI();
		rssi_best = (rssi > rssi_best) ? rssi : rssi_best;
		time_screen_saver = millis();

		if (!RefreshFav) {
			EEPROM.write(EEPROM_ADR_STATE, STATE_FAVORITE);
			HaveFav = false;
			for (int i = 0; i < 10; i++) {
				//NoFav
				if (EEPROM.read(EEPROM_ADR_TUNE_FAV[i]) != 255) {
					FirstFav = i;
					HaveFav = true;
				}
			}
			RefreshFav = true;
      
			//channel=channel_from_index(channelIndex);            // get 0...48 index depending of current channel
		} // handling of keys

		if (digitalRead(buttonUp) == LOW || FS_BUTTON_DIR == 1) {         // channel UP
			delay(KEY_DEBOUNCE); // debounce
			lfavs++;
			if (lfavs > FirstFav)
			lfavs = 0;
			channelIndex = EEPROM.read(EEPROM_ADR_TUNE_FAV[lfavs]);
			if (channelIndex != 255) {
				drawScreen.FavSel(lfavs + 1);
				channel = channel_from_index(channelIndex);     // get 0...48 index depending of current channel
				time_screen_saver = millis();
				beep(50);                                       // beep & debounce
				delay(KEY_DEBOUNCE);                            // debounce
				channel > CHANNEL_MAX ? channel = CHANNEL_MIN : false;
				if (channelIndex > CHANNEL_MAX_INDEX)
				channelIndex = CHANNEL_MIN_INDEX;
       
				// drawScreen.seekMode(state);
				EEPROM.write(EEPROM_ADR_TUNE, channelIndex);
        
				//Serial.println(channelIndex);
			} else {
				lfavs--;
			}
		}

		if (digitalRead(buttonDown) == LOW || FS_BUTTON_DIR == 2) { // channel DOWN
			delay(KEY_DEBOUNCE); // debounce
			lfavs--;
			if (lfavs < 0)    lfavs = FirstFav;

			channelIndex = EEPROM.read(EEPROM_ADR_TUNE_FAV[lfavs]);
			if (channelIndex != 255) {
				drawScreen.FavSel(lfavs + 1);
				channel = channel_from_index(channelIndex);     // get 0...48 index depending of current channel
				time_screen_saver = millis();
				beep(50);                                       // beep & debounce
				delay(KEY_DEBOUNCE);                            // debounce

				channel < CHANNEL_MIN ? channel = CHANNEL_MAX : false;
				if (channelIndex > CHANNEL_MAX_INDEX) // negative overflow
					channelIndex = CHANNEL_MAX_INDEX;

				//drawScreen.seekMode(state);
				EEPROM.write(EEPROM_ADR_TUNE, channelIndex);
			} else {
				lfavs++;
			}
		}

		if (HaveFav == false)
		drawScreen.NoFav();
		// IF YOU DONT HAVE FAVS
		else {
			//delay(KEY_DEBOUNCE);      // debounce
			state = STATE_SCREEN_SAVER;
			// IF YOU HAVE FAVS
		}
		
		OSDParams[0] = 4;               // this is FAV menu
		OSDParams[1] = pgm_read_word_near(channelFreqTable + channelIndex);
		OSDParams[2] = lfavs + 1;
		SendToOSD(); //UPDATE OSD
	}

	/*****************************************/
	/*   Processing MANUAL MODE / SEEK MODE  */
	/*****************************************/
	if (state == STATE_MANUAL || state == STATE_SEEK) {
		// read rssi
		wait_rssi_ready();
		rssi = readRSSI();
		FS_BUTTON_DIR = FSButtonDirection();

		channel = channel_from_index(channelIndex);     // get 0...48 index depending of current channel
		if (state == STATE_MANUAL) {        // MANUAL MODE
			OSDParams[0] = 3;                 // this is MANUAL MODE

			// handling of keys
			if (digitalRead(buttonUp) == LOW || FS_BUTTON_DIR == 1) {       // channel UP
				time_screen_saver = millis();
				beep(50);                                               // beep & debounce
				delay(KEY_DEBOUNCE);                                    // debounce
				FS_BUTTON_DIR = 0;
				channelIndex++;
				channel++;
				channel > CHANNEL_MAX ? channel = CHANNEL_MIN : false;
				if (channelIndex > CHANNEL_MAX_INDEX)
				channelIndex = CHANNEL_MIN_INDEX;
			}
			if (digitalRead(buttonDown) == LOW || FS_BUTTON_DIR == 2) { // channel DOWN
				time_screen_saver = millis();
				beep(50);                         // beep & debounce
				delay(KEY_DEBOUNCE);              // debounce
				FS_BUTTON_DIR = 0;
				channelIndex--;
				channel--;
				channel < CHANNEL_MIN ? channel = CHANNEL_MAX : false;
				if (channelIndex > CHANNEL_MAX_INDEX)          // negative overflow
				channelIndex = CHANNEL_MAX_INDEX;
			}

			if (OSDParams[1] != pgm_read_word_near(channelFreqTable + channelIndex)) {
				OSDParams[1] = pgm_read_word_near(channelFreqTable + channelIndex);
				
				// UPDATE OSD
				SendToOSD();                                 
			}
			 // order by frequency
			if (!settings_orderby_channel)  channelIndex = pgm_read_byte_near(channelList + channel);

		}

		// handling for seek mode after screen and RSSI has been fully processed
		if (state == STATE_SEEK) {        // SEEK MODE
			OSDParams[0] = 2; 		  	  //this is AUTO MODE
			// recalculate rssi_seek_threshold
			((int)((float)rssi_best * (float)(RSSI_SEEK_TRESHOLD / 100.0)) > rssi_seek_threshold) ? (rssi_seek_threshold = (int)((float)rssi_best * (float)(RSSI_SEEK_TRESHOLD / 100.0))) : false;

			if (!seek_found) { // search if not found
				if ((!force_seek) && (rssi > rssi_seek_threshold)) {               // check for found channel
					seek_found = 1;
					time_screen_saver = millis();
					// beep twice as notice of lock
					// beep(100);
					// delay(100);
					//  beep(100);
				} else { // seeking itself
					force_seek = 0;
					// next channel
					channel += seek_direction;
					if (channel > CHANNEL_MAX) {
            
						// calculate next pass new seek threshold
						rssi_seek_threshold = (int)((float)rssi_best * (float)(RSSI_SEEK_TRESHOLD / 100.0));
						channel = CHANNEL_MIN;
						rssi_best = 0;
					} else if (channel < CHANNEL_MIN) {
						// calculate next pass new seek threshold
						rssi_seek_threshold = (int)((float)rssi_best * (float)(RSSI_SEEK_TRESHOLD / 100.0));
						channel = CHANNEL_MAX;
						rssi_best = 0;
					}
					rssi_seek_threshold = rssi_seek_threshold < 5 ? 5 : rssi_seek_threshold;       // make sure we are not stopping on everyting
					channelIndex = pgm_read_byte_near(channelList + channel);
				}
			} else { // seek was successful
			}
			FS_BUTTON_DIR = FSButtonDirection();
			if (digitalRead(buttonUp) == LOW || digitalRead(buttonDown) == LOW || FS_BUTTON_DIR == 2 || FS_BUTTON_DIR == 1) {     // restart seek if key pressed
				if (digitalRead(buttonUp) == LOW || FS_BUTTON_DIR == 1)
				seek_direction = 1;
				else
				seek_direction = -1;
				beep(50);               // beep & debounce
				FS_BUTTON_DIR = 0;
				delay(KEY_DEBOUNCE);    // debounce
				force_seek = 1;
				seek_found = 0;
				time_screen_saver = 0;
			}

			SendToOSD(); //UPDATE OSD
		}
   
		// change to screensaver after lock and 5 seconds has passed.
		if (((time_screen_saver + 5000 < millis()) && (time_screen_saver != 0) && (rssi > 50)) ||
				((time_screen_saver != 0 && time_screen_saver + (SCREENSAVER_TIMEOUT * 1000) < millis()))) {
			state = STATE_SCREEN_SAVER;
			OSDParams[0] = -99;         // CLEAR OSD
			SendToOSD();                // UPDATE OSD
		}

		//teza
		if (last_channel_index != channelIndex) { // tune channel on demand
			drawScreen.updateSeekMode(state, channelIndex, channel, rssi, pgm_read_word_near(channelFreqTable + channelIndex), rssi_seek_threshold, seek_found);
			OSDParams[1] = pgm_read_word_near(channelFreqTable + channelIndex);
			SendToOSD(); //UPDATE OSD
		}
	}

	/****************************/
	/*   Processing SCAN MODE   */
	/****************************/
	else if (state == STATE_SCAN || state == STATE_RSSI_SETUP) {
		OSDParams[0] = -1;                        // N/A for the moment
		SendToOSD();                              // UPDATE OSD

		// force tune on new scan start to get right RSSI value
		if (scan_start) {
			scan_start = 0;
			setChannelModule(channelIndex);
			last_channel_index = channelIndex;
		}

		// print bar for spectrum
		wait_rssi_ready();
		// value must be ready
		rssi = readRSSI();

		if (state == STATE_SCAN) {
			if (rssi > RSSI_SEEK_TRESHOLD) {
				if (rssi_best < rssi)
				rssi_best = rssi;
			}
		}

		uint8_t bestChannelName = pgm_read_byte_near(channelNames + channelIndex);
		uint16_t bestChannelFrequency = pgm_read_word_near(channelFreqTable + channelIndex);

		drawScreen.updateBandScanMode((state == STATE_RSSI_SETUP), channel, rssi, bestChannelName, bestChannelFrequency, rssi_setup_min_a, rssi_setup_max_a);

		// next channel
		if (channel < CHANNEL_MAX) {
			channel++;
		} else {
			channel = CHANNEL_MIN;
			if (state == STATE_RSSI_SETUP) {
				if (!rssi_setup_run--) {
					
					// setup done
					rssi_min_a = rssi_setup_min_a;
					rssi_max_a = rssi_setup_max_a;
					if (rssi_max_a < 125)                        	  	     // user probably did not turn on the VTX during calibration
					rssi_max_a = RSSI_MAX_VAL;
					
					// save 16 bit
					EEPROM.write(EEPROM_ADR_RSSI_MIN_A_L, (rssi_min_a & 0xff));
					EEPROM.write(EEPROM_ADR_RSSI_MIN_A_H, (rssi_min_a >> 8));
					// save 16 bit
					EEPROM.write(EEPROM_ADR_RSSI_MAX_A_L, (rssi_max_a & 0xff));
					EEPROM.write(EEPROM_ADR_RSSI_MAX_A_H, (rssi_max_a >> 8));

#ifdef USE_DIVERSITY
					if (isDiversity()) {                            	   // only calibrate RSSI B when diversity is detected.
						rssi_min_b = rssi_setup_min_b;
						rssi_max_b = rssi_setup_max_b;
						if (rssi_max_b < 125)                              // user probably did not turn on the VTX during calibration
						rssi_max_b = RSSI_MAX_VAL;
						
						// save 16 bit
						EEPROM.write(EEPROM_ADR_RSSI_MIN_B_L, (rssi_min_b & 0xff));
						EEPROM.write(EEPROM_ADR_RSSI_MIN_B_H, (rssi_min_b >> 8));
						// save 16 bit
						EEPROM.write(EEPROM_ADR_RSSI_MAX_B_L, (rssi_max_b & 0xff));
						EEPROM.write(EEPROM_ADR_RSSI_MAX_B_H, (rssi_max_b >> 8));
					}
#endif
					state = EEPROM.read(EEPROM_ADR_STATE);
					beep(1000);
				}
			}
		}
		
		// new scan possible by press scan
		FS_BUTTON_DIR = FSButtonDirection();
		if (digitalRead(buttonUp) == LOW || FS_BUTTON_DIR == 1) { // force new full new scan
			beep(50);               // beep & debounce
			delay(KEY_DEBOUNCE);    // debounce
			last_state = 255;       // force redraw by fake state change ;-)
			channel = CHANNEL_MIN;
			scan_start = 1;
			rssi_best = 0;
			FS_BUTTON_DIR = 0;
		}
		// update index after channel change
		channelIndex = pgm_read_byte_near(channelList + channel);
	}

	/****************************/
	/*      SETUP_MENU   */
	/****************************/
	if (state == STATE_SETUP_MENU) {
		// simple menu
		char menu_id = 0;
		in_menu = 1;
		drawScreen.setupMenu();
		OSDParams[0] = 1;               //this is main menu
		OSDParams[1] = menu_id + 1;     //By defaut=lt goes over manual
		SendToOSD();
		int editing = -1;
		do {
			in_menu_time_out = 50;
			drawScreen.updateSetupMenu(menu_id, settings_beeps, settings_orderby_channel, call_sign, editing);

			// wait for next key press or time out
			while (--in_menu_time_out && ((digitalRead(buttonMode) == HIGH) && (digitalRead(buttonUp) == HIGH) && (digitalRead(buttonDown) == HIGH) && FSButtonDirection() == 0))   
				delay(100);       // timeout delay

			if (in_menu_time_out <= 0) {
				state = state_last_used;
				break;            // Timed out, Don't save...
			}

			if (digitalRead(buttonMode) == LOW) { // channel UP
				
				// do something about the users selection
				switch (menu_id) {
				case 0:                           // Channel Order Channel/Frequency
					settings_orderby_channel = !settings_orderby_channel;
					break;
				case 1:                           // Beeps enable/disable
					settings_beeps = !settings_beeps;
					break;
				case 2:                           // Edit Call Sign
					editing++;
					if (editing > 9)
					editing = -1;
					break;
				case 3:                           // Calibrate RSSI
					in_menu = 0;
					for (uint8_t loop = 0; loop < 10; loop++) {
						
#define RSSI_SETUP_BEEP 25
						beep(RSSI_SETUP_BEEP);  // beep & debounce
						delay(RSSI_SETUP_BEEP); // debounce
					}
					state = STATE_RSSI_SETUP;
					break;
				case 4:
					in_menu = 0; // save & exit menu
					state = STATE_SAVE;
					break;
				}
			} else if (digitalRead(buttonUp) == LOW || FS_BUTTON_DIR == 1) {
				if (editing == -1) {
					menu_id--;
				} else { // change current letter in place
					call_sign[editing]++;
					call_sign[editing] > '}' ? call_sign[editing] = ' ' : false; // loop to oter end
				}
			} else if (digitalRead(buttonDown) == LOW || FS_BUTTON_DIR == 2) {
				if (editing == -1) {
					menu_id++;
				} else { // change current letter in place
					call_sign[editing]--;
					call_sign[editing] < ' ' ? call_sign[editing] = '}' : false; // loop to oter end
				}
			}

			if (menu_id > 4)  menu_id = 0;
			else if (menu_id < 0)  menu_id = 4;

			OSDParams[0] = 1;               //this is main menu
			OSDParams[1] = menu_id + 1;     //By defaut=lt goes over manual
			SendToOSD();
			beep(50);                       // beep & debounce
			do {
				delay(150);             // wait for button release
			} while (editing == -1 && (digitalRead(buttonMode) == LOW || digitalRead(buttonUp) == LOW || digitalRead(buttonDown) == LOW || FSButtonDirection() == 1 || FSButtonDirection() == 2));
			
		} while (in_menu);
	}

	/*****************************/
	/*   General house keeping   */
	/*****************************/
	if (last_channel_index != channelIndex) { // tune channel on demand
		setChannelModule(channelIndex);
		last_channel_index = channelIndex;
		// keep time of tune to make sure that RSSI is stable when required
		time_of_tune = millis();
		// give 3 beeps when tuned to give feedback of correct start
		if (first_tune) {
			first_tune = 0;
#define UP_BEEP 100
			beep(UP_BEEP);
			delay(UP_BEEP);
			beep(UP_BEEP);
			delay(UP_BEEP);
			beep(UP_BEEP);
		}
	}
}

/*******************/
/*   SUB ROUTINES  */
/*******************/
void beep(uint16_t time)  {
	digitalWrite(led, HIGH);
	if (settings_beeps)
	digitalWrite(buzzer, LOW); // activate beep
	delay(time / 2);
	digitalWrite(led, LOW);
	digitalWrite(buzzer, HIGH);
}

uint8_t channel_from_index(uint8_t channelIndex)  {
	uint8_t loop = 0;
	uint8_t channel = 0;

	for (loop = 0; loop <= CHANNEL_MAX; loop++) {
		if (pgm_read_byte_near(channelList + loop) == channelIndex) {
			channel = loop;
			break;
		}
	}
	return channel;
}

void wait_rssi_ready()  {
	time_screen_saver2 = millis();
	// CHECK FOR MINIMUM DELAY
	// check if RSSI is stable after tune by checking the time
	uint16_t tune_time = millis() - time_of_tune;
	if (tune_time < MIN_TUNE_TIME)
	// wait until tune time is full filled
	delay(MIN_TUNE_TIME - tune_time);
}

//char * toArray(int number)
//    {
//        int n = log10(number) + 1;
//        int i;
//      char *numberArray = calloc(n, sizeof(char));
//        for ( i = 0; i < n; ++i, number /= 10 )
//        {
//            numberArray[i] = number % 10;
//        }
//        return numberArray;
//    }

uint16_t readRSSI()  {
#ifdef USE_DIVERSITY
	return readRSSI(-1);
}

uint16_t readRSSI(char receiver)  {
#endif
	int rssi = 0;
	int rssiA = 0;

#ifdef USE_DIVERSITY
	int rssiB = 0;
#endif
	for (uint8_t i = 0; i < RSSI_READS; i++) {
		analogRead(rssiPinA);
		rssiA += analogRead(rssiPinA);//random(RSSI_MAX_VAL-200, RSSI_MAX_VAL);//

#ifdef USE_DIVERSITY
		analogRead(rssiPinB);
		rssiB += analogRead(rssiPinB);//random(RSSI_MAX_VAL-200, RSSI_MAX_VAL);//
#endif

#ifdef Debug
		rssiB += 1;     // random(RSSI_MAX_VAL - 200, RSSI_MAX_VAL); //
#endif
	}
	rssiA = rssiA / RSSI_READS;      // average of RSSI_READS readings

#ifdef USE_DIVERSITY
	rssiB = rssiB / RSSI_READS;      // average of RSSI_READS readings
#endif
	// special case for RSSI setup
	if (state == STATE_RSSI_SETUP) { // RSSI setup
		if (rssiA < rssi_setup_min_a)       rssi_setup_min_a = rssiA;
		if (rssiA > rssi_setup_max_a)       rssi_setup_max_a = rssiA;

#ifdef USE_DIVERSITY
		if (rssiB < rssi_setup_min_b) rssi_setup_min_b = rssiB;
		if (rssiB > rssi_setup_max_b) rssi_setup_max_b = rssiB;
#endif
	}

	rssiA = map(rssiA, rssi_min_a, rssi_max_a, 1, 100);     // scale from 1..100%
#ifdef USE_DIVERSITY
	rssiB = map(rssiB, rssi_min_b, rssi_max_b, 1, 100);     // scale from 1..100%
	if (receiver == -1) { // no receiver was chosen using diversity
		switch (diversity_mode) {
		case useReceiverAuto:
			
			// select receiver
			if ((int)abs((float)(((float)rssiA - (float)rssiB) / (float)rssiB) * 100.0) >= DIVERSITY_CUTOVER) {
				if (rssiA > rssiB && diversity_check_count > 0)
				diversity_check_count--;
				if (rssiA < rssiB && diversity_check_count < DIVERSITY_MAX_CHECKS)
				diversity_check_count++;
				
				// have we reached the maximum number of checks to switch receivers?
				if (diversity_check_count == 0 || diversity_check_count >= DIVERSITY_MAX_CHECKS)
				receiver = (diversity_check_count == 0) ? useReceiverA : useReceiverB;
				else
				receiver = active_receiver;
			} else {
				receiver = active_receiver;
			}
			break;
		case useReceiverB:
			receiver = useReceiverB;
			break;
		case useReceiverA:
		default:
			receiver = useReceiverA;
		}

		// set the antenna LED and switch the video
		setReceiver(receiver);
	}
#endif

#ifdef USE_DIVERSITY
	if (receiver == useReceiverA || state == STATE_RSSI_SETUP) {
#endif
		rssi = rssiA;
#ifdef USE_DIVERSITY
	} else {
		rssi = rssiB;
	}
#endif

	//SEND RSSI FEEDBACK
	if (((time_screen_saver2 != 0 && time_screen_saver2 + 8000 < millis())) && (state == STATE_SCREEN_SAVER)) {
		if ((p_active_receiver != active_receiver) || ((rssi - 60 > p_rssi) || (rssi + 60 < p_rssi))) {
			p_active_receiver = active_receiver;
			p_rssi = rssi;
			OSDParams[0] = rssiA;           //rssiA; //this is  A
			OSDParams[1] = rssiB;           //rssiB; //this is  B
			OSDParams[2] = receiver;        //active_receiver; //CUrrent reciever
			OSDParams[3] = -1;              //THIS is for rssi method
			SendToOSD();
			time_screen_saver2 = 1;
		}
	}
	return constrain(rssi, 1, 100);     //  clip values to only be within this range.
}

void setReceiver(uint8_t receiver)  {
#ifdef USE_DIVERSITY
	if (receiver == useReceiverA) {
#ifdef USE_FAST_SWITCHING
		PORTC = (PORTC & B11111101) | B00000001; 
		//  This turns off receiverB_led and turns on receiverA_led simultaniously, this does however breaks the adaptability of receiverA_led/receiverB_led in settings.h
#else
		digitalWrite(receiverB_led, LOW);
		digitalWrite(receiverA_led, HIGH);
#endif
	} else {
#ifdef USE_FAST_SWITCHING
		PORTC = (PORTC & B11111110) | B00000010;
		//  This turns off receiverA_led and turns on receiverB_led simultaniously
#else
		digitalWrite(receiverA_led, LOW);
		digitalWrite(receiverB_led, HIGH);
#endif
	}
#else
	digitalWrite(receiverA_led, HIGH);
#endif

	active_receiver = receiver;
}

void setChannelModule(uint8_t channel)  {
	uint8_t i;
	uint16_t channelData;
	channelData = pgm_read_word_near(channelTable + channel);

	// bit bash out 25 bits of data
	// Order: A0-3, !R/W, D0-D19
	// A0=0, A1=0, A2=0, A3=1, RW=0, D0-19=0
	SERIAL_ENABLE_HIGH();
	delayMicroseconds(1);
	//delay(2);
	SERIAL_ENABLE_LOW();

	SERIAL_SENDBIT0();
	SERIAL_SENDBIT0();
	SERIAL_SENDBIT0();
	SERIAL_SENDBIT1();
	SERIAL_SENDBIT0();

	// remaining zeros
	for (i = 20; i > 0; i--)	SERIAL_SENDBIT0();

	// Clock the data in
	SERIAL_ENABLE_HIGH();
	//delay(2);
	delayMicroseconds(1);
	SERIAL_ENABLE_LOW();

	// Second is the channel data from the lookup table
	// 20 bytes of register data are sent, but the MSB 4 bits are zeros
	// register address = 0x1, write, data0-15=channelData data15-19=0x0
	SERIAL_ENABLE_HIGH();
	SERIAL_ENABLE_LOW();

	// Register 0x1
	SERIAL_SENDBIT1();
	SERIAL_SENDBIT0();
	SERIAL_SENDBIT0();
	SERIAL_SENDBIT0();

	// Write to register
	SERIAL_SENDBIT1();

	// D0-D15
	//   note: loop runs backwards as more efficent on AVR
	for (i = 16; i > 0; i--) {
		if (channelData & 0x1)        // Is bit high or low?
			SERIAL_SENDBIT1();
		else
			SERIAL_SENDBIT0();

		channelData >>= 1;           // Shift bits along to check the next one
	}

	// Remaining D16-D19
	for (i = 4; i > 0; i--)	SERIAL_SENDBIT0();

	// Finished clocking data in
	SERIAL_ENABLE_HIGH();
	delayMicroseconds(1);
	//delay(2);

	digitalWrite(slaveSelectPin, LOW);
	digitalWrite(spiClockPin, LOW);
	digitalWrite(spiDataPin, LOW);
}


void SERIAL_SENDBIT1() {
	digitalWrite(spiClockPin, LOW);
	delayMicroseconds(1);

	digitalWrite(spiDataPin, HIGH);
	delayMicroseconds(1);
	digitalWrite(spiClockPin, HIGH);
	delayMicroseconds(1);

	digitalWrite(spiClockPin, LOW);
	delayMicroseconds(1);
}


void SERIAL_SENDBIT0() {
	digitalWrite(spiClockPin, LOW);
	delayMicroseconds(1);

	digitalWrite(spiDataPin, LOW);
	delayMicroseconds(1);
	digitalWrite(spiClockPin, HIGH);
	delayMicroseconds(1);

	digitalWrite(spiClockPin, LOW);
	delayMicroseconds(1);
}


void SERIAL_ENABLE_LOW() {
	delayMicroseconds(1);
	digitalWrite(slaveSelectPin, LOW);
	delayMicroseconds(1);
}


void SERIAL_ENABLE_HIGH() {
	delayMicroseconds(1);
	digitalWrite(slaveSelectPin, HIGH);
	delayMicroseconds(1);
}


void FillTemp_Tune_fav(int FavChannelx)  {
	for (int i = 0; i < 10; i++) {
		if (temp_EEPROM_ADR_TUNE_FAV[i] == 255 && FavChannelx != 255) { //not used  gc9n
			temp_EEPROM_ADR_TUNE_FAV[i] = FavChannelx;
			i = 12;
		}
	}
}

void SendToOSD() { 				 //GC9N
	if (settings_OSD == true || OSDParams[0] == -99) {
		char one[5];
		char two[5];
		char three[5];
		char four[5];
		char blank[5] = " ";
		char combined[20] = { 0 };

		itoa(OSDParams[0], one, 10);
		itoa(OSDParams[1], two, 10);
		itoa(OSDParams[2], three, 10);
		itoa(OSDParams[3], four, 10);

		char ClearScreen[20] = " CLEAR ";
		char RssiScreen[20] = " DRAWRSSI";

		strcat(combined, OSDCommand);

		if (OSDParams[0] == -99) { 			// CLEARSCREEN
			for (uint8_t i = 0; i < 20; i++)
				combined[i] = ClearScreen[i];
		}

		if (OSDParams[3] == -1) {			 // DRAW_RSSI
			for (uint8_t i = 0; i < 20; i++)
				combined[i] = RssiScreen[i];
		}

		strcat(combined, blank);
		strcat(combined, one);
		strcat(combined, blank);
		strcat(combined, two);
		strcat(combined, blank);
		strcat(combined, three);

		Serial.println(combined);
		OSDParams[3] = 0;
	}
}

int8_t FSButtonDirection() { 			 //gc9n
	char dir;                   //1 UP 2 DOWN

	while (Serial.available() > 0) {
		dir = Serial.read();
		if (dir == ']') {
			FS_BUTTON_DIR = 2;
			return 2;
		} else if (dir == '[') {
			FS_BUTTON_DIR = 1;
			return 1;
		} else {
			FS_BUTTON_DIR = 0;
			return 0;
		}
	}
}
