gc9n/rx5808-Diversity-RealAcc-Compatible/(commit log)

2016-10-17 Update settings.h
    #define DIVERSITY_CUTOVER 4
    #define DIVERSITY_MAX_CHECKS 7
    try to fix sync problems.
    [settings.h]
2016-11-10 bug fixes and visual updates
    [rx5808-pro-diversityGc9n.ino]
2016-11-19 Port manipulation used for faster switching, to be enabled or disabled using feature toggle USE_FAST_SWITCHING.
2016-12-12 Add files via upload
    OSD support - Buttons Support
2017-04-09 Revert "starting to clean up some code"
    [rx5808-pro-diversityGc9n.ino]
